PaulT95/smart-grind-by-weight/media/Digital_knob_installation/Step_0b.png

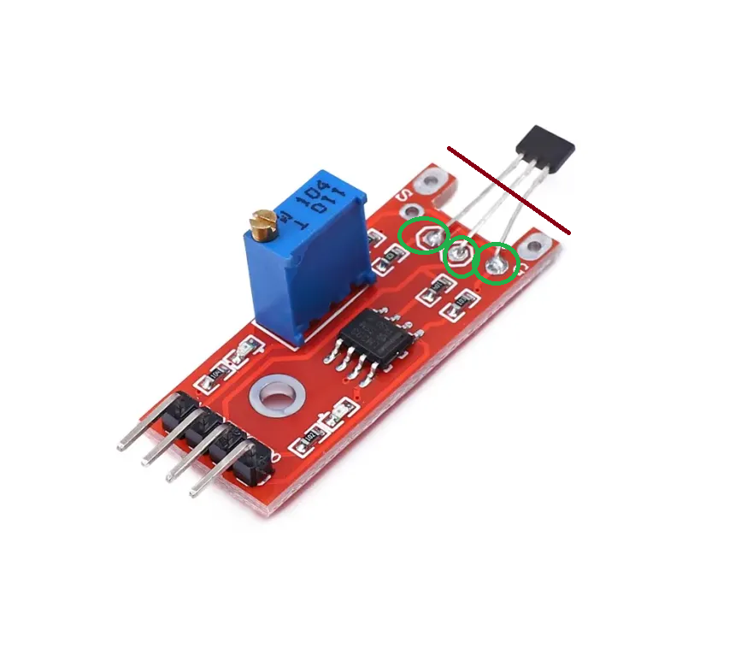
media/Digital_knob_installation/Step_0b.png
