PaulT95/smart-grind-by-weight/3d_files/Hall_sensor_adapter.stl

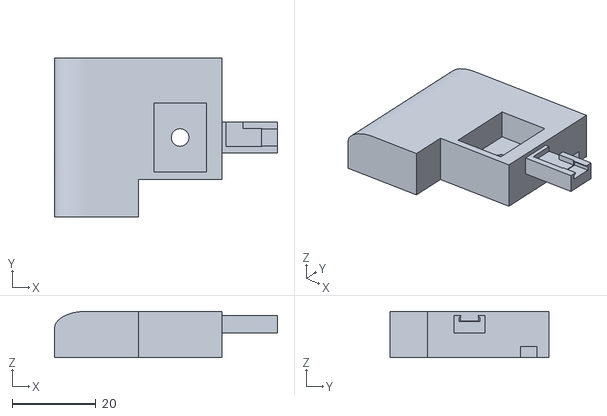
[picture p3: CAD file, 2026-10-31]
3d_files/Hall_sensor_adapter.stl
53.2 x 38.0 x 11.0
