PaulT95/smart-grind-by-weight/media/Digital_knob_installation/Step_0a.jpg

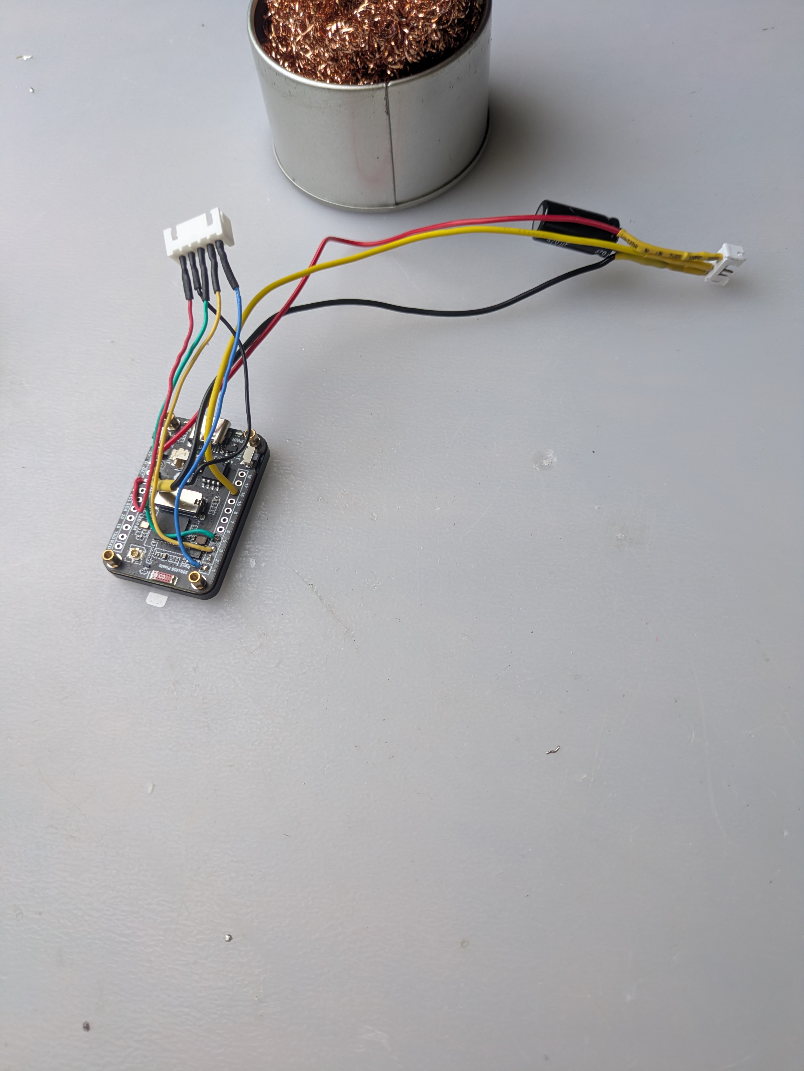
media/Digital_knob_installation/Step_0a.jpg
