PaulT95/smart-grind-by-weight/media/Digital_knob_installation/Step_3.jpg

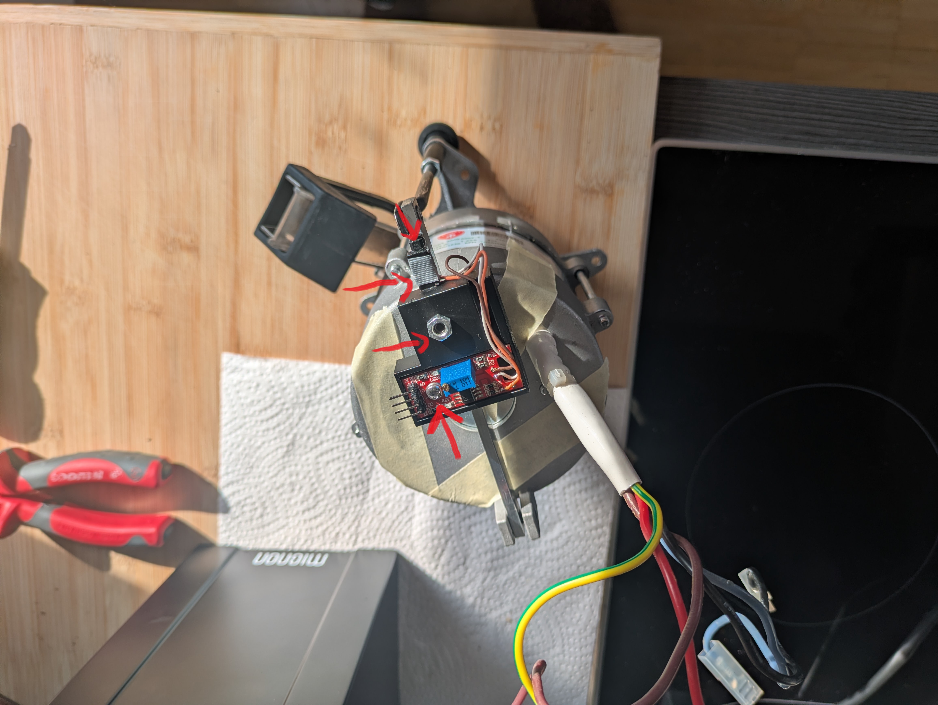
media/Digital_knob_installation/Step_3.jpg
