PaulT95/smart-grind-by-weight/media/Digital_knob_installation/Step_4.jpg

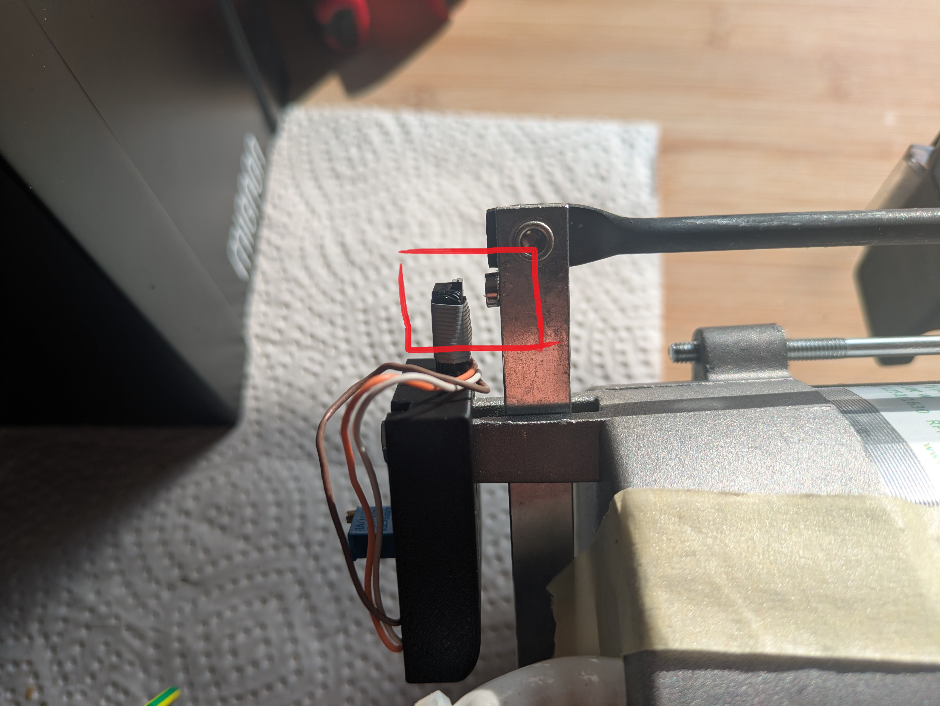
media/Digital_knob_installation/Step_4.jpg
