PaulT95/smart-grind-by-weight/media/Digital_knob_installation/Step_5.jpg

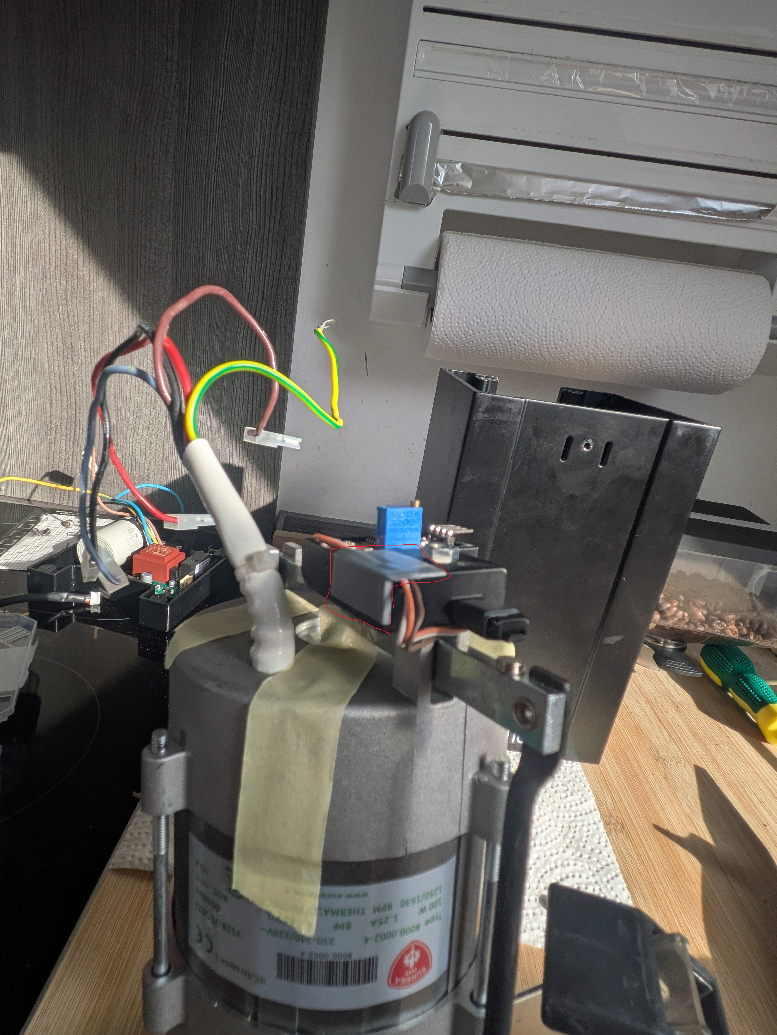
media/Digital_knob_installation/Step_5.jpg
