PaulT95/smart-grind-by-weight/media/Digital_knob_installation/Step_6.jpg

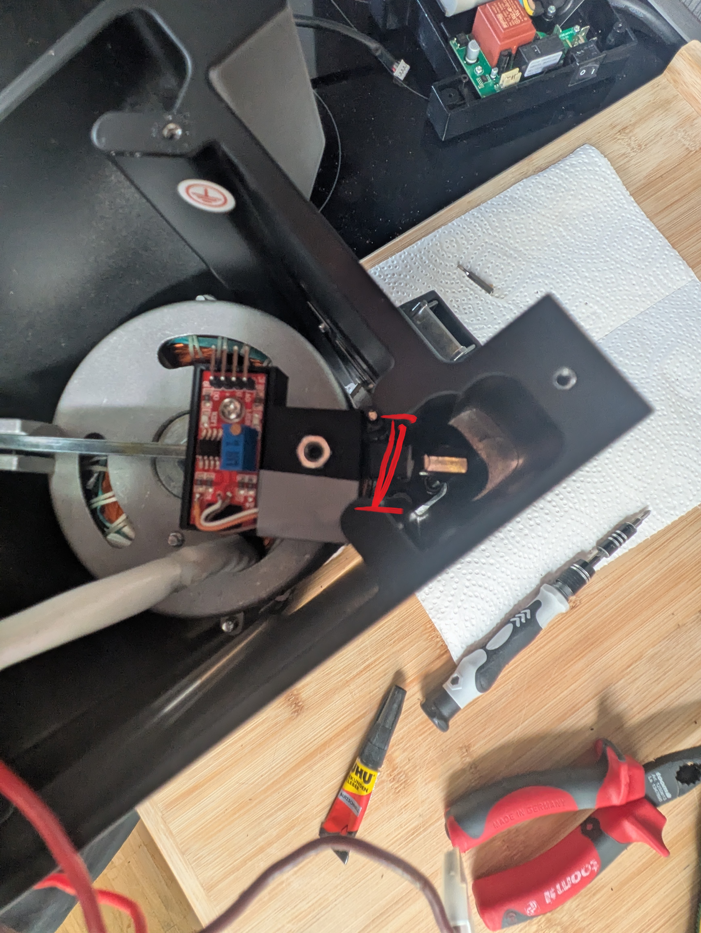
media/Digital_knob_installation/Step_6.jpg
