PaulT95/smart-grind-by-weight/src/config/hardware.h

#pragma once

//==============================================================================
// HARDWARE CONFIGURATION CONSTANTS
//==============================================================================
// This file contains hardware-specific configuration values that define the
// physical characteristics and constraints of the ESP32-S3 coffee grinder system.
// These values are tied to the specific hardware implementation and should only
// be modified when changing hardware components.

//------------------------------------------------------------------------------
// GPIO PIN ASSIGNMENTS
//------------------------------------------------------------------------------
// Touch Controller (I2C)
#define HW_TOUCH_I2C_SDA_PIN 47                                                // I2C data pin for capacitive touch controller
#define HW_TOUCH_I2C_SCL_PIN 48                                                // I2C clock pin for capacitive touch controller
#define HW_TOUCH_I2C_ADDRESS 0x38                                              // I2C address of FT3168 touch controller

// Display Controller (QSPI)
#ifndef HW_DISPLAY_VARIANT_V2
#define HW_DISPLAY_VARIANT_V2 0                                               // V1 remains the default hardware target
#endif

#if HW_DISPLAY_VARIANT_V2 != 0 && HW_DISPLAY_VARIANT_V2 != 1
#error "HW_DISPLAY_VARIANT_V2 must be either 0 or 1"
#endif

#if HW_DISPLAY_VARIANT_V2
#define HW_DISPLAY_REVISION "v2"
#define HW_DISPLAY_DESCRIPTION "Waveshare ESP32-S3 Touch AMOLED 1.64 V2"
#define HW_RELEASE_FIRMWARE_SUFFIX "-waveshare-164-v2"
#define HW_DISPLAY_CS_PIN 46                                                   // V2 PCB chip select for SH8601 display controller
#else
#define HW_DISPLAY_REVISION "v1"
#define HW_DISPLAY_DESCRIPTION "Waveshare ESP32-S3 Touch AMOLED 1.64 V1"
#define HW_RELEASE_FIRMWARE_SUFFIX ""
#define HW_DISPLAY_CS_PIN 9                                                    // V1 PCB chip select for CO5300 display controller
#endif
#define HW_DISPLAY_SCK_PIN 10                                                  // SPI clock for display controller
#define HW_DISPLAY_D0_PIN 11                                                   // SPI data line 0 (QSPI mode)
#define HW_DISPLAY_D1_PIN 12                                                   // SPI data line 1 (QSPI mode)
#define HW_DISPLAY_D2_PIN 13                                                   // SPI data line 2 (QSPI mode)
#define HW_DISPLAY_D3_PIN 14                                                   // SPI data line 3 (QSPI mode)
#define HW_DISPLAY_RESET_PIN 21                                                // Display reset pin

// Load Cell ADC Pins
#define HW_LOADCELL_DOUT_PIN 3                                                 // HX711 data output pin
#if HW_DISPLAY_VARIANT_V2
#define HW_LOADCELL_SCK_PIN 1                                                  // V2 wiring; GPIO2 is bypassed on this board revision
#else
#define HW_LOADCELL_SCK_PIN 2                                                  // V1 HX711 serial clock pin
#endif

// Motor Control
#if HW_DISPLAY_VARIANT_V2
#define HW_MOTOR_RELAY_PIN 16                                                  // V2: GPIO18 is shared with TP_INT and must not drive the grinder
#else
#define HW_MOTOR_RELAY_PIN 18                                                  // V1 grinder motor control relay
#endif
#define HW_GRINDER_SETTLING_TIME_MS 500                                        // Startup transient immunity (tune based on mechanical rigidity, 0 to disable)

//------------------------------------------------------------------------------
// LOAD CELL ADC SPECIFICATIONS
//------------------------------------------------------------------------------
// Sample rate configuration
#define HW_LOADCELL_SAMPLE_RATE_SPS 10                                         // Current sample rate setting
#define HW_LOADCELL_SAMPLE_INTERVAL_MS (1000 / HW_LOADCELL_SAMPLE_RATE_SPS)   // Calculated sample interval

// Calibration validation
#define HW_LOADCELL_CAL_MIN_ADC_VALUE 1000                                    // Minimum ADC value to confirm weight placed on scale

//------------------------------------------------------------------------------
// DISPLAY SPECIFICATIONS  
//------------------------------------------------------------------------------
#define HW_DISPLAY_WIDTH_PX 280                                                // LCD width in pixels
#define HW_DISPLAY_HEIGHT_PX 456                                               // LCD height in pixels
#define HW_DISPLAY_ROTATION_DEG 0                                              // Display rotation angle
#if HW_DISPLAY_VARIANT_V2
#define HW_DISPLAY_OFFSET_X_PX 20                                              // SH8601 framebuffer column offset
#define HW_DISPLAY_QSPI_FREQUENCY_HZ 40000000                                  // Waveshare V2 reference QSPI clock
#else
#define HW_DISPLAY_OFFSET_X_PX 0                                               // V1 display positioning offset
#define HW_DISPLAY_IPS_INVERT_X 180                                            // IPS X-axis inversion setting
#define HW_DISPLAY_IPS_INVERT_Y 24                                             // IPS Y-axis inversion setting
#define HW_DISPLAY_COLOR_ORDER 20                                              // Color channel ordering
#endif
#define HW_DISPLAY_MINIMAL_BRIGHTNESS_PERCENT 15                               // Minimum brightness percentage (to avoid too dim to see)

//------------------------------------------------------------------------------
// HALL EFFECT SENSOR (KY-024)
//------------------------------------------------------------------------------
#define HW_HALL_ADC_PIN 5                                                      // ADC1 channel 4, safe with Wi-Fi/BLE
#define HW_HALL_NUM_SAMPLES 50                                                 // Averaging samples per reading
#define HW_HALL_NUM_CAL_POINTS 6                                               // 6-point calibration table [0 to 5 are usually enough were 0 is touching]
#define HW_HALL_PREFS_NS "hall"                                                // Preferences namespace for calibration

//------------------------------------------------------------------------------
// SERIAL COMMUNICATION
//------------------------------------------------------------------------------
#define HW_SERIAL_BAUD_RATE 115200                                             // UART baud rate for debug/logging output
