PaulT95/smart-grind-by-weight/src/hardware/hardware_manager.h

#pragma once
#include <Preferences.h>
#include "display_manager.h"
#include "WeightSensor.h"
#include "grinder.h"
#include "HallSensor.h"
#include "../controllers/autotune_controller.h"

class GrindController; // Forward declaration

class HardwareManager {
private:
    DisplayManager display_manager;
    WeightSensor weight_sensor;
    Grinder grinder;
    HallSensor hall_sensor;
    Preferences preferences;
    AutoTuneController autotune_controller;
    bool initialized;
    GrindController* grind_controller; // Reference to get grinding state
    
public:
    void init();
    void update();
    void set_grind_controller(GrindController* gc) {
        grind_controller = gc;
        // Initialize autotune controller with grind controller reference
        autotune_controller.init(&weight_sensor, &grinder, gc);
    }
    
    DisplayManager* get_display() { return &display_manager; }
    WeightSensor* get_weight_sensor() { return &weight_sensor; }
    WeightSensor* get_load_cell() { return &weight_sensor; } // Legacy compatibility
    Grinder* get_grinder() { return &grinder; }
    HallSensor* get_hall_sensor() { return &hall_sensor; }
    Preferences* get_preferences() { return &preferences; }
    AutoTuneController* get_autotune_controller() { return &autotune_controller; }
    
    bool is_initialized() const { return initialized; }
};
