PaulT95/smart-grind-by-weight/src/network/device_api.cpp

#include "device_api.h"

#include <algorithm>
#include <cmath>
#include <cctype>
#include <cstring>
#include <LittleFS.h>
#include <esp_random.h>

#include "../controllers/grind_controller.h"
#include "../controllers/profile_controller.h"
#include "../config/constants.h"
#include "../hardware/WeightSensor.h"
#include "../hardware/grinder.h"
#include "../hardware/hardware_manager.h"
#include "../hardware/HallSensor.h"
#include "../system/screensaver_settings.h"
#include "../system/operation_interlock.h"
#include "device_web_server.h"
#include "gaggimate_status_client.h"

DeviceApi device_api;

namespace {
bool contains_json_string(const char* json, const char* key, const char* value) {
    if (!json || !key || !value) return false;
    const String needle = "\"" + String(key) + "\"";
    const char* cursor = strstr(json, needle.c_str());
    if (!cursor) return false;
    cursor += needle.length();
    while (*cursor == ' ' || *cursor == '\t' || *cursor == '\r' || *cursor == '\n') ++cursor;
    if (*cursor++ != ':') return false;
    while (*cursor == ' ' || *cursor == '\t' || *cursor == '\r' || *cursor == '\n') ++cursor;
    if (*cursor++ != '\"') return false;
    const size_t value_length = strlen(value);
    return strncmp(cursor, value, value_length) == 0 && cursor[value_length] == '\"';
}

bool extract_json_uint(const char* json, const char* key, uint32_t& value) {
    if (!json || !key) return false;
    const String needle = "\"" + String(key) + "\"";
    const char* cursor = strstr(json, needle.c_str());
    if (!cursor) return false;
    cursor += needle.length();
    while (*cursor == ' ' || *cursor == '\t' || *cursor == '\r' || *cursor == '\n') ++cursor;
    if (*cursor++ != ':') return false;
    while (*cursor == ' ' || *cursor == '\t' || *cursor == '\r' || *cursor == '\n') ++cursor;
    if (*cursor < '0' || *cursor > '9') return false;

    uint64_t parsed = 0;
    while (*cursor >= '0' && *cursor <= '9') {
        parsed = parsed * 10U + static_cast<uint8_t>(*cursor - '0');
        if (parsed > 0xFFFFFFFFULL) return false;
        ++cursor;
    }
    while (*cursor == ' ' || *cursor == '\t' || *cursor == '\r' || *cursor == '\n') ++cursor;
    if (*cursor != ',' && *cursor != '}') return false;
    value = static_cast<uint32_t>(parsed);
    return true;
}

bool websocket_origin_allowed(AsyncWebServerRequest* request) {
    if (!request || !request->hasHeader("Origin")) return true;
    const AsyncWebHeader* origin_header = request->getHeader("Origin");
    if (!origin_header) return false;
    return origin_header->value() == ("http://" + request->host());
}

bool valid_local_host(const String& host) {
    if (host.isEmpty() || host.length() > 63) return false;
    for (size_t index = 0; index < host.length(); ++index) {
        const char value = host[index];
        if (!isalnum(static_cast<unsigned char>(value)) && value != '.' && value != '-') {
            return false;
        }
    }
    return true;
}

const char* api_phase_name(const GrindController& controller) {
    switch (controller.get_phase()) {
        case GrindPhase::IDLE:
            return "IDLE";
        case GrindPhase::INITIALIZING:
        case GrindPhase::SETUP:
        case GrindPhase::TARING:
        case GrindPhase::TARE_CONFIRM:
            return "PREPARING";
        case GrindPhase::PRIME:
        case GrindPhase::PRIME_SETTLING:
        case GrindPhase::PURGE_CONFIRM:
            return "PRIMING";
        case GrindPhase::PREDICTIVE:
        case GrindPhase::PULSE_EXECUTE:
        case GrindPhase::TIME_ADDITIONAL_PULSE:
            return "GRINDING";
        case GrindPhase::TIME_GRINDING:
            return controller.is_grind_paused() ? "PAUSED" : "GRINDING";
        case GrindPhase::MANUAL_GRINDING:
            return "GRINDING";
        case GrindPhase::PULSE_DECISION:
        case GrindPhase::PULSE_SETTLING:
            return "COASTING";
        case GrindPhase::FINAL_SETTLING:
            return "FINAL_SETTLING";
        case GrindPhase::COMPLETED:
            return "COMPLETED";
        case GrindPhase::TIMEOUT:
            return "TIMEOUT";
    }
    return "IDLE";
}
}

void DeviceApi::init(AsyncWebServer* server, HardwareManager* hardware,
                     GrindController* grind_controller, ProfileController* profile_controller) {
    if (initialized_ || !server || !hardware || !grind_controller || !profile_controller) return;
    hardware_ = hardware;
    grind_controller_ = grind_controller;
    profile_controller_ = profile_controller;
    command_queue_ = xQueueCreate(8, sizeof(Command));
    settings_mutex_ = xSemaphoreCreateMutex();
    if (!command_queue_ || !settings_mutex_) {
        hardware_ = nullptr;
        grind_controller_ = nullptr;
        profile_controller_ = nullptr;
        return;
    }
    websocket_.onEvent([this](AsyncWebSocket* ws, AsyncWebSocketClient* client,
                              AwsEventType type, void* arg, uint8_t* data, size_t len) {
        handle_event(ws, client, type, arg, data, len);
    });
    websocket_.handleHandshake(websocket_origin_allowed);
    server->addHandler(&websocket_);
    configure_settings_routes(server);
    // Avoid mistaking a previous boot's result for a newly queued request.
    next_settings_id_ = esp_random();
    refresh_settings_cache();
    initialized_ = true;
}

bool form_bool(const String& value) {
    return value == "1" || value == "true" || value == "on";
}

void DeviceApi::update() {
    if (!initialized_) return;
    if (settings_cache_dirty_.exchange(false)) refresh_settings_cache();
    websocket_.cleanupClients(MAX_CLIENTS);
    const uint32_t now = millis();
    if (now - last_publish_ms_ < PUBLISH_INTERVAL_MS) return;
    last_publish_ms_ = now;

    const String message = build_state_message();
    for (size_t index = 0; index < MAX_CLIENTS; ++index) {
        auto& slot = client_ids_[index];
        const uint32_t id = slot.load();
        if (id == 0) {
            backpressure_skips_[index].store(0);
            continue;
        }
        if (!websocket_.hasClient(id)) {
            slot.store(0);
            backpressure_skips_[index].store(0);
            continue;
        }
        if (!websocket_.availableForWrite(id)) {
            uint8_t skipped = backpressure_skips_[index].load();
            if (skipped < MAX_CONSECUTIVE_BACKPRESSURE_SKIPS) ++skipped;
            backpressure_skips_[index].store(skipped);
            if (skipped >= MAX_CONSECUTIVE_BACKPRESSURE_SKIPS) {
                LOG_BLE("[WEB] Closing WebSocket client %lu after sustained backpressure\n",
                        static_cast<unsigned long>(id));
                websocket_.close(id, 1013, "client remained too slow");
                slot.store(0);
                backpressure_skips_[index].store(0);
            }
            continue;
        }
        backpressure_skips_[index].store(0);
        websocket_.text(id, message);
    }
}

bool DeviceApi::process_commands() {
    if (!initialized_) return false;
    if (applying_settings_id_) return true;
    bool settings_changed = false;
    Command command{};
    while (xQueueReceive(command_queue_, &command, 0) == pdTRUE) {
        // Keep the idle check and its action together with controller updates.
        const auto control_lock = grind_controller_->lock_control();
        switch (command.action) {
            case CommandAction::START: {
                if (device_web_server.is_ota_active() || device_web_server.is_ota_preparing()) {
                    send_ack(command, "start", false, "firmware update is active");
                    break;
                }
                if (grind_controller_->get_phase() != GrindPhase::IDLE) {
                    send_ack(command, "start", false, "grinder is not idle");
                    break;
                }
                const auto profile = profile_controller_->snapshot();
                const GrindMode mode = profile.mode;
                WeightSensor* sensor = hardware_->get_weight_sensor();
                if (mode == GrindMode::WEIGHT &&
                    (!sensor || sensor->has_hardware_fault())) {
                    send_ack(command, "start", false, "load cell is not ready");
                    break;
                }
                grind_controller_->set_grind_profile_id(profile.current_profile);
                const float target_weight = profile.profiles[profile.current_profile].weight;
                const uint32_t target_time_ms = static_cast<uint32_t>(
                    profile.profiles[profile.current_profile].time_seconds * 1000.0f + 0.5f);
                const bool started = grind_controller_->start_grind(target_weight, target_time_ms, mode);
                send_ack(command, "start", started, started ? "grind started" : "grind could not start");
                break;
            }
            case CommandAction::START_MANUAL:
                if (device_web_server.is_ota_active() || device_web_server.is_ota_preparing()) {
                    send_ack(command, "start_manual", false, "firmware update is active");
                } else if (grind_controller_->get_phase() != GrindPhase::IDLE) {
                    send_ack(command, "start_manual", false, "grinder is not idle");
                } else {
                    const bool started = grind_controller_->start_grind(0.0f, 0, GrindMode::MANUAL);
                    send_ack(command, "start_manual", started,
                             started ? "manual grind started" : "grind could not start");
                }
                break;
            case CommandAction::STOP:
                if (!grind_controller_->is_active()) {
                    send_ack(command, "stop", false, "grinder is not active");
                } else {
                    grind_controller_->stop_grind();
                    send_ack(command, "stop", true, "grind stopped");
                }
                break;
            case CommandAction::DISMISS:
                if (grind_controller_->get_phase() != GrindPhase::COMPLETED &&
                    grind_controller_->get_phase() != GrindPhase::TIMEOUT) {
                    send_ack(command, "dismiss", false, "nothing to dismiss");
                } else {
                    grind_controller_->return_to_idle();
                    const bool dismissed = grind_controller_->get_phase() == GrindPhase::IDLE;
                    send_ack(command, "dismiss", dismissed,
                             dismissed ? "result dismissed" : "history completion is pending");
                }
                break;
            case CommandAction::TARE: {
                WeightSensor* sensor = hardware_->get_weight_sensor();
                if (grind_controller_->get_phase() != GrindPhase::IDLE) {
                    send_ack(command, "tare", false, "grinder is not idle");
                } else if (!sensor || sensor->has_hardware_fault() || sensor->get_sample_count() <= 0) {
                    send_ack(command, "tare", false, "load cell is not ready");
                } else if (sensor->is_tare_in_progress()) {
                    send_ack(command, "tare", false, "tare is already in progress");
                } else {
                    sensor->tareNoDelay();
                    send_ack(command, "tare", true, "tare started");
                }
                break;
            }
            case CommandAction::SELECT_PROFILE:
                if (grind_controller_->get_phase() != GrindPhase::IDLE) {
                    send_ack(command, "select_profile", false, "grinder is not idle");
                    break;
                }
                profile_controller_->set_current_profile(command.profile_index);
                settings_changed = true;
                LOG_BLE("[WEB] Active profile changed to %s\n",
                        profile_controller_->get_current_name());
                send_ack(command, "select_profile", true, "profile selected");
                break;
            case CommandAction::SET_MODE:
                if (grind_controller_->get_phase() != GrindPhase::IDLE) {
                    send_ack(command, "set_mode", false, "grinder is not idle");
                    break;
                }
                profile_controller_->set_grind_mode(
                    command.grind_mode == 1 ? GrindMode::TIME : GrindMode::WEIGHT);
                settings_changed = true;
                send_ack(command, "set_mode", true, "grind mode selected");
                break;
            case CommandAction::APPLY_SETTINGS: {
                settings_operation_token_ = operation_interlock().try_acquire();
                if (!settings_operation_token_) {
                    set_settings_result(command.request_id, "busy");
                    break;
                }
                applying_settings_id_ = command.request_id;
                settings_persisted_ = apply_settings(command.settings);
                // Even a failed multi-key save can change stored values. Return
                // now so UI runtime refresh finishes before any later command.
                refresh_settings_cache();
                return true;
            }
        }
    }
    if (settings_changed) refresh_settings_cache();
    return settings_changed;
}

uint32_t DeviceApi::reserve_settings_result() {
    xSemaphoreTake(settings_mutex_, portMAX_DELAY);
    for (const auto& result : settings_results_) {
        if (strcmp(result.status, "pending") == 0) {
            xSemaphoreGive(settings_mutex_);
            return 0;
        }
    }
    if (++next_settings_id_ == 0) ++next_settings_id_;
    const uint32_t id = next_settings_id_;
    settings_results_[next_settings_result_] = {id, "pending"};
    next_settings_result_ = (next_settings_result_ + 1) % 4;
    xSemaphoreGive(settings_mutex_);
    return id;
}

void DeviceApi::set_settings_result(uint32_t id, const char* status) {
    xSemaphoreTake(settings_mutex_, portMAX_DELAY);
    for (auto& result : settings_results_) {
        if (result.id == id) { result.status = status; break; }
    }
    xSemaphoreGive(settings_mutex_);
}

const char* DeviceApi::settings_result(uint32_t id) {
    const char* status = "unknown";
    xSemaphoreTake(settings_mutex_, portMAX_DELAY);
    for (const auto& result : settings_results_) {
        if (id && result.id == id) { status = result.status; break; }
    }
    xSemaphoreGive(settings_mutex_);
    return status; // All statuses are static literals, not pointers into a slot.
}

void DeviceApi::complete_settings_application(bool runtime_applied) {
    if (!applying_settings_id_) return;
    // Keep other operations excluded through persistence, cache and UI refresh.
    set_settings_result(applying_settings_id_, settings_persisted_ && runtime_applied ? "saved" : "failed");
    operation_interlock().release(settings_operation_token_);
    settings_operation_token_ = 0;
    applying_settings_id_ = 0;
}

void DeviceApi::handle_event(AsyncWebSocket*, AsyncWebSocketClient* client,
                             AwsEventType type, void* arg, uint8_t* data, size_t len) {
    if (!client) return;
    if (type == WS_EVT_CONNECT) {
        add_client(client);
        return;
    }
    if (type == WS_EVT_DISCONNECT || type == WS_EVT_ERROR) {
        remove_client(client->id());
        return;
    }
    if (type != WS_EVT_DATA || !arg || !data) return;
    auto* info = static_cast<AwsFrameInfo*>(arg);
    if (!info->final || info->index != 0 || info->len != len || info->opcode != WS_TEXT || len > 255) {
        client->close(1009, "single text frames only");
        return;
    }
    queue_command(client->id(), data, len);
}

void DeviceApi::add_client(AsyncWebSocketClient* client) {
    for (size_t index = 0; index < MAX_CLIENTS; ++index) {
        auto& slot = client_ids_[index];
        uint32_t empty = 0;
        if (slot.compare_exchange_strong(empty, client->id())) {
            backpressure_skips_[index].store(0);
            client->keepAlivePeriod(20);
            client->text(build_state_message());
            return;
        }
    }
    client->close(1013, "too many clients");
}

void DeviceApi::remove_client(uint32_t client_id) {
    for (size_t index = 0; index < MAX_CLIENTS; ++index) {
        auto& slot = client_ids_[index];
        uint32_t expected = client_id;
        if (slot.compare_exchange_strong(expected, 0)) {
            backpressure_skips_[index].store(0);
        }
    }
}

void DeviceApi::queue_command(uint32_t client_id, const uint8_t* data, size_t len) {
    char json[256];
    memcpy(json, data, len);
    json[len] = '\0';
    uint32_t request_id = 0;
    const bool has_request_id = extract_json_uint(json, "rid", request_id);
    if (!contains_json_string(json, "type", "command")) {
        send_ack(client_id, request_id, has_request_id, "unknown", false, "invalid message type");
        return;
    }

    Command command{};
    command.client_id = client_id;
    command.request_id = request_id;
    command.has_request_id = has_request_id;
    command.action = CommandAction::STOP;
    const char* action = nullptr;
    if (contains_json_string(json, "action", "start")) {
        action = "start";
        command.action = CommandAction::START;
    } else if (contains_json_string(json, "action", "start_manual")) {
        action = "start_manual";
        command.action = CommandAction::START_MANUAL;
    } else if (contains_json_string(json, "action", "stop")) {
        action = "stop";
        command.action = CommandAction::STOP;
    } else if (contains_json_string(json, "action", "dismiss")) {
        action = "dismiss";
        command.action = CommandAction::DISMISS;
    } else if (contains_json_string(json, "action", "tare")) {
        action = "tare";
        command.action = CommandAction::TARE;
    } else if (contains_json_string(json, "action", "select_profile")) {
        action = "select_profile";
        command.action = CommandAction::SELECT_PROFILE;
        uint32_t profile = 0;
        if (!extract_json_uint(json, "profile", profile) || profile >= USER_PROFILE_COUNT) {
            send_ack(command, action, false, "invalid profile");
            return;
        }
        command.profile_index = static_cast<int>(profile);
    } else if (contains_json_string(json, "action", "set_mode")) {
        action = "set_mode";
        command.action = CommandAction::SET_MODE;
        if (contains_json_string(json, "mode", "weight")) {
            command.grind_mode = 0;
        } else if (contains_json_string(json, "mode", "time")) {
            command.grind_mode = 1;
        } else {
            send_ack(command, action, false, "invalid grind mode");
            return;
        }
    } else {
        send_ack(client_id, request_id, has_request_id, "unknown", false, "unsupported action");
        return;
    }

    if (xQueueSend(command_queue_, &command, 0) != pdTRUE) {
        send_ack(command, action, false, "command queue busy");
    }
}

void DeviceApi::configure_settings_routes(AsyncWebServer* server) {
    server->on(AsyncURIMatcher::exact("/api/v1/settings/result"), HTTP_GET, [this](AsyncWebServerRequest* request) {
        uint32_t id = 0;
        bool valid = request->hasParam("id");
        if (valid) {
            const String value = request->getParam("id")->value();
            valid = !value.isEmpty() && value.length() <= 10;
            uint64_t parsed = 0;
            for (size_t i = 0; valid && i < value.length(); ++i) {
                valid = value[i] >= '0' && value[i] <= '9';
                if (valid) parsed = parsed * 10 + (value[i] - '0');
            }
            valid = valid && parsed > 0 && parsed <= UINT32_MAX;
            if (valid) id = static_cast<uint32_t>(parsed);
        }
        if (!valid) {
            request->send(400, "application/json", "{\"error\":\"Invalid settings request ID\"}");
            return;
        }
        const char* status = settings_result(id);
        char body[96];
        snprintf(body, sizeof(body), "{\"request_id\":%lu,\"status\":\"%s\"}",
                 static_cast<unsigned long>(id), status);
        auto* response = request->beginResponse(strcmp(status, "unknown") == 0 ? 404 : 200,
                                                "application/json", body);
        response->addHeader("Cache-Control", "no-store");
        request->send(response);
    });
    server->on(AsyncURIMatcher::exact("/api/v1/profile"), HTTP_POST, [this](AsyncWebServerRequest* request) {
        if (!websocket_origin_allowed(request)) {
            request->send(403, "application/json", "{\"error\":\"Request origin is not allowed\"}");
            return;
        }
        queue_profile_selection(request);
    });
    server->on(AsyncURIMatcher::exact("/api/v1/settings"), HTTP_GET, [this](AsyncWebServerRequest* request) {
        AsyncWebServerResponse* response = request->beginResponse(200, "application/json", settings_json());
        response->addHeader("Cache-Control", "no-store");
        request->send(response);
    });
    server->on(AsyncURIMatcher::exact("/api/v1/settings"), HTTP_POST, [this](AsyncWebServerRequest* request) {
        if (!websocket_origin_allowed(request)) {
            request->send(403, "application/json", "{\"error\":\"Request origin is not allowed\"}");
            return;
        }
        queue_settings_update(request);
    });
}

bool DeviceApi::queue_profile_selection(AsyncWebServerRequest* request) {
    if (!request->hasParam("profile", true)) {
        request->send(400, "application/json", "{\"error\":\"Missing profile\"}");
        return false;
    }
    const String value = request->getParam("profile", true)->value();
    if (value != "0" && value != "1" && value != "2") {
        request->send(400, "application/json", "{\"error\":\"Profile must be 0, 1 or 2\"}");
        return false;
    }
    if (grind_controller_->get_phase() != GrindPhase::IDLE) {
        request->send(409, "application/json", "{\"error\":\"Profiles can only be changed while the grinder is idle\"}");
        return false;
    }

    Command command{};
    command.action = CommandAction::SELECT_PROFILE;
    command.profile_index = value.toInt();
    if (xQueueSend(command_queue_, &command, 0) != pdTRUE) {
        request->send(503, "application/json", "{\"error\":\"Command queue is busy; try again\"}");
        return false;
    }
    request->send(202, "application/json", "{\"accepted\":true}");
    return true;
}

bool DeviceApi::queue_settings_update(AsyncWebServerRequest* request) {
    static const char* required[] = {
        "current_profile", "grind_mode", "weight0", "weight1", "weight2",
        "time0", "time1", "time2", "auto_start", "auto_return", "purge_mode",
        "purge_amount_g", "freshness_hours", "coast_ratio", "logging_enabled",
        "swipe_enabled", "brightness_percent", "screensaver_brightness_percent",
        "screensaver_startup", "screensaver_sleep", "screensaver_idle_timeout_s",
        "screensaver_startup_timeout_s",
        "screensaver_style", "bluetooth_startup"
    };
    for (const char* field : required) {
        if (!request->hasParam(field, true)) {
            request->send(400, "application/json", String("{\"error\":\"Missing field: ") + field + "\"}");
            return false;
        }
    }

    auto value = [request](const char* name) { return request->getParam(name, true)->value(); };
    DeviceSettingsUpdate settings{};
    settings.current_profile = value("current_profile").toInt();
    settings.grind_mode = value("grind_mode").toInt();
    for (int i = 0; i < 3; ++i) {
        settings.profile_weights[i] = value((String("weight") + i).c_str()).toFloat();
        settings.profile_times[i] = value((String("time") + i).c_str()).toFloat();
    }
    settings.auto_start = form_bool(value("auto_start"));
    if (request->hasParam("auto_start_threshold_g", true)) {
        settings.auto_start_threshold_g = value("auto_start_threshold_g").toFloat();
    } else {
        Preferences auto_preferences;
        if (auto_preferences.begin("autogrind", true)) {
            settings.auto_start_threshold_g = auto_preferences.getFloat(
                "start_delta_g", USER_AUTO_GRIND_TRIGGER_DELTA_G);
            auto_preferences.end();
        }
    }
    settings.auto_return = form_bool(value("auto_return"));
    settings.purge_mode = value("purge_mode").toInt();
    settings.purge_amount_g = value("purge_amount_g").toFloat();
    settings.freshness_hours = value("freshness_hours").toFloat();
    settings.coast_ratio = value("coast_ratio").toFloat();
    settings.motor_latency_ms = request->hasParam("motor_latency_ms", true)
                                    ? value("motor_latency_ms").toFloat()
                                    : grind_controller_->get_motor_response_latency();
    settings.logging_enabled = form_bool(value("logging_enabled"));
    settings.swipe_enabled = form_bool(value("swipe_enabled"));
    settings.brightness_percent = value("brightness_percent").toInt();
    settings.screensaver_brightness_percent = value("screensaver_brightness_percent").toInt();
    settings.screensaver_startup = form_bool(value("screensaver_startup"));
    settings.screensaver_sleep = form_bool(value("screensaver_sleep"));
    const long screensaver_idle_timeout_s = value("screensaver_idle_timeout_s").toInt();
    const long screensaver_startup_timeout_s = value("screensaver_startup_timeout_s").toInt();
    // Older web pages predate panel-off settings. Preserve the stored values
    // rather than rejecting the whole form or silently resetting the option.
    settings.has_display_off_enabled = request->hasParam("display_off_enabled", true);
    settings.has_display_off_delay_s = request->hasParam("display_off_delay_s", true);
    const long display_off_delay_s = settings.has_display_off_delay_s
                                         ? value("display_off_delay_s").toInt()
                                         : settings.display_off_delay_s;
    settings.screensaver_idle_timeout_s = static_cast<uint16_t>(screensaver_idle_timeout_s);
    settings.screensaver_startup_timeout_s = static_cast<uint8_t>(screensaver_startup_timeout_s);
    settings.display_off_enabled = settings.has_display_off_enabled
                                       ? form_bool(value("display_off_enabled"))
                                       : settings.display_off_enabled;
    settings.display_off_delay_s = static_cast<uint16_t>(display_off_delay_s);
    const String screensaver_style = value("screensaver_style");
    strncpy(settings.screensaver_style, screensaver_style.c_str(), sizeof(settings.screensaver_style) - 1);
    const String gaggimate_host = request->hasParam("gaggimate_host", true)
                                      ? value("gaggimate_host")
                                      : gaggimate_status_client.configured_host();
    strncpy(settings.gaggimate_host, gaggimate_host.c_str(), sizeof(settings.gaggimate_host) - 1);
    settings.bluetooth_startup = form_bool(value("bluetooth_startup"));

    bool valid = settings.current_profile >= 0 && settings.current_profile < USER_PROFILE_COUNT &&
                 settings.grind_mode >= 0 && settings.grind_mode <= 1 &&
                 std::isfinite(settings.auto_start_threshold_g) &&
                 settings.auto_start_threshold_g >= USER_AUTO_GRIND_TRIGGER_MIN_G &&
                 settings.auto_start_threshold_g <= USER_AUTO_GRIND_TRIGGER_MAX_G &&
                 settings.purge_mode >= 0 && settings.purge_mode <= 1 &&
                 std::isfinite(settings.purge_amount_g) &&
                 settings.purge_amount_g >= GRIND_PURGE_AMOUNT_MIN_G &&
                 settings.purge_amount_g <= GRIND_PURGE_AMOUNT_MAX_G &&
                 std::isfinite(settings.freshness_hours) && settings.freshness_hours >= 0.5f &&
                 settings.freshness_hours <= 48.0f && std::isfinite(settings.coast_ratio) &&
                 settings.coast_ratio >= GRIND_LATENCY_TO_COAST_RATIO_MIN &&
                 settings.coast_ratio <= GRIND_LATENCY_TO_COAST_RATIO_MAX &&
                 std::isfinite(settings.motor_latency_ms) &&
                 settings.motor_latency_ms >= GRIND_AUTOTUNE_LATENCY_MIN_MS &&
                 settings.motor_latency_ms <= GRIND_AUTOTUNE_LATENCY_MAX_MS &&
                 std::fabs(settings.motor_latency_ms / GRIND_MOTOR_LATENCY_MANUAL_STEP_MS -
                           std::round(settings.motor_latency_ms /
                                      GRIND_MOTOR_LATENCY_MANUAL_STEP_MS)) < 0.001f &&
                 settings.brightness_percent >= HW_DISPLAY_MINIMAL_BRIGHTNESS_PERCENT &&
                 settings.brightness_percent <= 100 &&
                 settings.screensaver_brightness_percent >= HW_DISPLAY_MINIMAL_BRIGHTNESS_PERCENT &&
                 settings.screensaver_brightness_percent <= 100 &&
                 screensaver_idle_timeout_s >= 0 && screensaver_idle_timeout_s <= 65535 &&
                 screensaver_startup_timeout_s >= 0 && screensaver_startup_timeout_s <= 255 &&
                 display_off_delay_s >= 0 && display_off_delay_s <= 65535 &&
                 ScreensaverSettings::is_valid_idle_timeout(settings.screensaver_idle_timeout_s) &&
                 ScreensaverSettings::is_valid_startup_timeout(settings.screensaver_startup_timeout_s) &&
                 ScreensaverSettings::is_valid_display_off_delay(settings.display_off_delay_s) &&
                 (screensaver_style == "orbit" || screensaver_style == "minimal" ||
                  screensaver_style == "blank" ||
                  (screensaver_style == "custom" && LittleFS.exists(BLE_IMAGE_FILENAME)) ||
                  (screensaver_style == "gaggimate" && valid_local_host(gaggimate_host)));
    for (int i = 0; i < 3 && valid; ++i) {
        valid = std::isfinite(settings.profile_weights[i]) &&
                profile_controller_->is_weight_valid(settings.profile_weights[i]) &&
                std::isfinite(settings.profile_times[i]) &&
                profile_controller_->is_time_valid(settings.profile_times[i]);
    }
    if (!valid) {
        request->send(400, "application/json", "{\"error\":\"One or more settings are outside the supported range\"}");
        return false;
    }
    if (grind_controller_->is_active()) {
        request->send(409, "application/json", "{\"error\":\"Stop the grinder before changing settings\"}");
        return false;
    }

    Command command{};
    command.action = CommandAction::APPLY_SETTINGS;
    command.settings = settings;
    command.request_id = reserve_settings_result();
    if (!command.request_id) {
        request->send(409, "application/json", "{\"error\":\"A settings save is still pending\"}");
        return false;
    }
    if (xQueueSend(command_queue_, &command, 0) != pdTRUE) {
        set_settings_result(command.request_id, "failed");
        request->send(503, "application/json", "{\"error\":\"Settings queue is busy; try again\"}");
        return false;
    }
    request->send(202, "application/json", String("{\"accepted\":true,\"request_id\":") + command.request_id + "}");
    return true;
}

bool DeviceApi::apply_settings(const DeviceSettingsUpdate& update) {
    if (!hardware_ || !profile_controller_ || !grind_controller_ || grind_controller_->is_active()) return false;
    DeviceSettingsUpdate settings = update;
    // Resolve omissions when executing, after earlier queued saves have applied.
    if (!settings.has_display_off_enabled || !settings.has_display_off_delay_s) {
        const auto stored_timing = ScreensaverSettings::load_timing();
        if (!settings.has_display_off_enabled) settings.display_off_enabled = stored_timing.display_off_enabled;
        if (!settings.has_display_off_delay_s) settings.display_off_delay_s = stored_timing.display_off_delay_s;
    }
    Preferences* grinder = hardware_->get_preferences();
    if (!grinder) return false;
    bool saved = profile_controller_->apply_web_settings(
            settings.current_profile,
            settings.grind_mode == 0 ? GrindMode::WEIGHT : GrindMode::TIME,
            settings.profile_weights, settings.profile_times);

    saved = (grinder->putInt(GrindController::PREF_KEY_GRINDER_MODE, settings.purge_mode) == sizeof(int32_t)) && saved;
    saved = (grinder->putFloat(GrindController::PREF_KEY_GRINDER_AMOUNT_G, settings.purge_amount_g) == sizeof(float)) && saved;
    saved = (grinder->putFloat(GrindController::PREF_KEY_GRIND_FRESHNESS_HOURS, settings.freshness_hours) == sizeof(float)) && saved;
    saved = grind_controller_->save_coast_ratio(settings.coast_ratio) && saved;
    saved = grind_controller_->save_motor_latency(settings.motor_latency_ms) && saved;

    auto put_bool = [](const char* name_space, const char* key, bool value) {
        Preferences preferences;
        if (!preferences.begin(name_space, false)) return false;
        const bool stored = preferences.putBool(key, value) == sizeof(bool);
        preferences.end();
        return stored;
    };
    saved = put_bool("autogrind", "auto_start", settings.auto_start) && saved;
    saved = put_bool("autogrind", "auto_return", settings.auto_return) && saved;
    Preferences auto_preferences;
    if (auto_preferences.begin("autogrind", false)) {
        saved = (auto_preferences.putFloat("start_delta_g", settings.auto_start_threshold_g) == sizeof(float)) && saved;
        auto_preferences.end();
    } else {
        saved = false;
    }
    saved = put_bool("logging", "enabled", settings.logging_enabled) && saved;
    saved = put_bool("swipe", "enabled", settings.swipe_enabled) && saved;
    saved = put_bool("screensaver", "startup", settings.screensaver_startup) && saved;
    saved = put_bool("screensaver", "sleep", settings.screensaver_sleep) && saved;
    saved = put_bool("bluetooth", "startup", settings.bluetooth_startup) && saved;

    Preferences brightness;
    if (brightness.begin("brightness", false)) {
        const bool normal_saved = brightness.putFloat("normal", settings.brightness_percent / 100.0f) == sizeof(float);
        saved = normal_saved && saved;
        saved = (brightness.putFloat("screensaver", settings.screensaver_brightness_percent / 100.0f) == sizeof(float)) && saved;
        brightness.end();
        if (normal_saved && hardware_->get_display()) {
            hardware_->get_display()->set_brightness(settings.brightness_percent / 100.0f);
        }
    } else {
        saved = false;
    }
    if (!ScreensaverSettings::save_timing(settings.screensaver_idle_timeout_s,
                                          settings.screensaver_startup_timeout_s,
                                          settings.display_off_enabled,
                                          settings.display_off_delay_s)) {
        saved = false;
    }
    Preferences screensaver;
    if (screensaver.begin("screensaver", false)) {
        const bool style_saved = screensaver.putString("style", settings.screensaver_style) == strlen(settings.screensaver_style);
        saved = style_saved && saved;
        const String stored_style = screensaver.getString("style", "");
        screensaver.end();
        const bool style_read = stored_style == "minimal" || stored_style == "orbit" ||
                                stored_style == "blank" || stored_style == "custom" ||
                                stored_style == "gaggimate";
        if (style_read) {
            saved = gaggimate_status_client.configure(stored_style == "gaggimate",
                                                      settings.gaggimate_host) && saved;
        } else {
            // Keep the active client unchanged when stored style is unreadable.
            saved = false;
        }
    } else {
        saved = false;
    }
    LOG_BLE("[WEB] Grinder settings %s\n", saved ? "updated" : "partly saved; storage or runtime setup failed");
    return saved;
}

String DeviceApi::settings_json() {
    if (!settings_mutex_) return "{}";
    xSemaphoreTake(settings_mutex_, portMAX_DELAY);
    const String copy = settings_json_cache_;
    xSemaphoreGive(settings_mutex_);
    return copy;
}

void DeviceApi::refresh_settings_cache() {
    if (!profile_controller_ || !hardware_ || !grind_controller_ || !settings_mutex_) return;
    const auto profile = profile_controller_->snapshot();
    auto read_bool = [](const char* name_space, const char* key, bool fallback) {
        Preferences preferences;
        if (!preferences.begin(name_space, true)) return fallback;
        const bool value = preferences.getBool(key, fallback);
        preferences.end();
        return value;
    };
    auto read_brightness = [](const char* key, float fallback) {
        Preferences preferences;
        if (!preferences.begin("brightness", true)) return fallback;
        const float value = preferences.getFloat(key, fallback);
        preferences.end();
        return value;
    };
    auto read_float = [](const char* name_space, const char* key, float fallback) {
        Preferences preferences;
        if (!preferences.begin(name_space, true)) return fallback;
        const float value = preferences.getFloat(key, fallback);
        preferences.end();
        return value;
    };
    Preferences* grinder = hardware_->get_preferences();
    const int purge_mode = grinder->getInt(GrindController::PREF_KEY_GRINDER_MODE, GRIND_PURGE_MODE_DEFAULT);
    const float purge_amount = grinder->getFloat(GrindController::PREF_KEY_GRINDER_AMOUNT_G, GRIND_PURGE_AMOUNT_DEFAULT_G);
    const float freshness = grinder->getFloat(GrindController::PREF_KEY_GRIND_FRESHNESS_HOURS, GRIND_FRESHNESS_DEFAULT_HOURS);
    const ScreensaverTimingSettings screensaver_timing = ScreensaverSettings::load_timing();
    Preferences screensaver_preferences;
    String screensaver_style = LittleFS.exists(BLE_IMAGE_FILENAME) ? "custom" : "minimal";
    if (screensaver_preferences.begin("screensaver", true)) {
        screensaver_style = screensaver_preferences.getString("style", screensaver_style);
        screensaver_preferences.end();
    }
    const String gaggimate_host = gaggimate_status_client.configured_host();

    char json[2048];
    snprintf(json, sizeof(json),
             "{\"api\":\"v1\",\"current_profile\":%d,\"grind_mode\":\"%s\","
             "\"profiles\":["
             "{\"id\":0,\"name\":\"%s\",\"weight\":%.2f,\"time\":%.2f},"
             "{\"id\":1,\"name\":\"%s\",\"weight\":%.2f,\"time\":%.2f},"
             "{\"id\":2,\"name\":\"%s\",\"weight\":%.2f,\"time\":%.2f}],"
             "\"automatic\":{\"start\":%s,\"threshold_g\":%.1f,\"return\":%s},"
             "\"purge\":{\"mode\":%d,\"amount_g\":%.2f,\"freshness_hours\":%.2f},"
             "\"coast_ratio\":%.2f,\"motor_latency_ms\":%.0f,"
             "\"logging_enabled\":%s,\"swipe_enabled\":%s,"
             "\"display\":{\"brightness\":%d,\"screensaver_brightness\":%d,"
             "\"screensaver_startup\":%s,\"screensaver_sleep\":%s,"
             "\"screensaver_idle_timeout_s\":%u,\"screensaver_startup_timeout_s\":%u,"
             "\"display_off_enabled\":%s,\"display_off_delay_s\":%u,"
             "\"screensaver_style\":\"%s\",\"has_custom_screensaver\":%s,"
             "\"gaggimate_host\":\"%s\"},"
             "\"bluetooth_startup\":%s}",
             profile.current_profile,
             profile.mode == GrindMode::TIME ? "time" : "weight",
             profile.profiles[0].name, profile.profiles[0].weight, profile.profiles[0].time_seconds,
             profile.profiles[1].name, profile.profiles[1].weight, profile.profiles[1].time_seconds,
             profile.profiles[2].name, profile.profiles[2].weight, profile.profiles[2].time_seconds,
             read_bool("autogrind", "auto_start", false) ? "true" : "false",
             std::clamp(read_float("autogrind", "start_delta_g", USER_AUTO_GRIND_TRIGGER_DELTA_G),
                        USER_AUTO_GRIND_TRIGGER_MIN_G, USER_AUTO_GRIND_TRIGGER_MAX_G),
             read_bool("autogrind", "auto_return", false) ? "true" : "false",
             purge_mode, purge_amount, freshness, grind_controller_->get_coast_ratio(),
             grind_controller_->get_motor_response_latency(),
             read_bool("logging", "enabled", true) ? "true" : "false",
             read_bool("swipe", "enabled", false) ? "true" : "false",
             static_cast<int>(read_brightness("normal", USER_SCREEN_BRIGHTNESS_NORMAL) * 100.0f + 0.5f),
             static_cast<int>(read_brightness("screensaver", USER_SCREEN_BRIGHTNESS_DIMMED) * 100.0f + 0.5f),
             read_bool("screensaver", "startup", false) ? "true" : "false",
             read_bool("screensaver", "sleep", false) ? "true" : "false",
             screensaver_timing.idle_timeout_s, screensaver_timing.startup_timeout_s,
             screensaver_timing.display_off_enabled ? "true" : "false",
             screensaver_timing.display_off_delay_s,
             screensaver_style.c_str(), LittleFS.exists(BLE_IMAGE_FILENAME) ? "true" : "false",
             gaggimate_host.c_str(),
             read_bool("bluetooth", "startup", true) ? "true" : "false");
    xSemaphoreTake(settings_mutex_, portMAX_DELAY);
    settings_json_cache_ = json;
    xSemaphoreGive(settings_mutex_);
}

void DeviceApi::send_ack(uint32_t client_id, uint32_t request_id, bool has_request_id,
                         const char* action, bool accepted, const char* reason) {
    if (!websocket_.hasClient(client_id) || !websocket_.availableForWrite(client_id)) return;
    char message[192];
    if (has_request_id) {
        snprintf(message, sizeof(message),
                 "{\"api\":\"v1\",\"type\":\"ack\",\"rid\":%lu,\"action\":\"%s\",\"accepted\":%s,\"reason\":\"%s\"}",
                 static_cast<unsigned long>(request_id), action,
                 accepted ? "true" : "false", reason);
    } else {
        snprintf(message, sizeof(message),
                 "{\"api\":\"v1\",\"type\":\"ack\",\"action\":\"%s\",\"accepted\":%s,\"reason\":\"%s\"}",
                 action, accepted ? "true" : "false", reason);
    }
    websocket_.text(client_id, message);
}

void DeviceApi::send_ack(const Command& command, const char* action, bool accepted,
                         const char* reason) {
    send_ack(command.client_id, command.request_id, command.has_request_id,
             action, accepted, reason);
}

String DeviceApi::build_state_message() {
    // Capture profile data before taking controller access; profile persistence
    // must not hold up the motor control loop through a network reader.
    const auto profile = profile_controller_->snapshot();
    const auto control_lock = grind_controller_->lock_control();
    WeightSensor* sensor = hardware_->get_weight_sensor();
    Grinder* grinder = hardware_->get_grinder();
    HallSensor* hall = hardware_->get_hall_sensor();
    const bool idle = grind_controller_->get_phase() == GrindPhase::IDLE;
    const GrindMode mode = idle ? profile.mode : grind_controller_->get_mode();
    const float target_weight = idle ? profile.profiles[profile.current_profile].weight
                                     : grind_controller_->get_target_weight();
    const uint32_t target_time_ms = idle
        ? static_cast<uint32_t>(profile.profiles[profile.current_profile].time_seconds * 1000.0f)
        : grind_controller_->get_target_time_ms();
    // The web metric is for a human-readable live display, so mirror the
    // steadier filtered value used by the on-device UI. The high-frequency raw
    // control samples remain available in the saved session trace.
    const float weight = sensor ? sensor->get_display_weight() : 0.0f;
    const float flow = sensor ? sensor->get_flow_rate() : 0.0f;
    const bool motor_running = grinder && grinder->is_grinding();

    // Knob state — safe to read at any time; HallSensor caches its last reading.
    const float dial = hall ? hall->get_dial_position() : NAN;
    const int32_t raw_adc = hall ? hall->get_raw_adc() : 0;
    const int32_t comp_adc = hall ? hall->get_comp_adc() : 0;
    const float temp_c = hall ? hall->get_chip_temperature() : NAN;
    const bool knob_calibrated = hall && hall->is_calibrated();
    const bool dial_valid = hall && !isnan(dial);

    // Format dial as "null" or a 2-decimal float for the JSON string.
    char dial_str[16];
    if (dial_valid) {
        snprintf(dial_str, sizeof(dial_str), "%.2f", dial);
    } else {
        snprintf(dial_str, sizeof(dial_str), "null");
    }

    char temp_str[16];
    if (!isnan(temp_c)) {
        snprintf(temp_str, sizeof(temp_str), "%.1f", temp_c);
    } else {
        snprintf(temp_str, sizeof(temp_str), "null");
    }

    char message[768];
    snprintf(message, sizeof(message),
             "{\"api\":\"v1\",\"type\":\"state\",\"seq\":%lu,\"timestamp_ms\":%lu,"
             "\"grind\":{\"active\":%s,\"phase\":\"%s\",\"mode\":\"%s\",\"profile\":%d,\"progress\":%d,"
             "\"target_weight\":%.2f,\"target_time_ms\":%lu},"
             "\"scale\":{\"weight\":%.2f,\"flow\":%.2f},"
             "\"motor\":{\"running\":%s},"
             "\"knob\":{\"calibrated\":%s,\"dial\":%s,\"raw_adc\":%ld,\"comp_adc\":%ld,\"temp_c\":%s},"
             "\"system\":{\"free_heap\":%u}}",
             static_cast<unsigned long>(sequence_.fetch_add(1) + 1), static_cast<unsigned long>(millis()),
             grind_controller_->is_active() ? "true" : "false",
             api_phase_name(*grind_controller_),
             mode == GrindMode::TIME ? "time" : mode == GrindMode::MANUAL ? "manual" : "weight",
             idle ? profile.current_profile : grind_controller_->get_session_descriptor().profile_id,
             grind_controller_->get_current_progress_percent(),
             target_weight,
             static_cast<unsigned long>(target_time_ms),
             weight, flow, motor_running ? "true" : "false",
             knob_calibrated ? "true" : "false",
             dial_str,
             static_cast<long>(raw_adc),
             static_cast<long>(comp_adc),
             temp_str,
             static_cast<unsigned int>(ESP.getFreeHeap()));
    return String(message);
}
