PaulT95/smart-grind-by-weight/src/ui/controllers/ready_controller.cpp

#include "ready_controller.h"

#include <Preferences.h>
#include <lvgl.h>
#include "../../config/constants.h"
#include "../../controllers/grind_mode_traits.h"
#include "../event_bridge_lvgl.h"
#include "../ui_manager.h"
#include "../../hardware/HallSensor.h"

ReadyUIController::ReadyUIController(UIManager* manager)
    : ui_manager_(manager) {}

void ReadyUIController::update() {
    const uint32_t now = millis();
    if (!ui_manager_) return;

    if (ui_manager_->state_machine &&
        ui_manager_->state_machine->is_state(UIState::READY) &&
        ui_manager_->current_tab == ReadyScreen::MANUAL_TAB_INDEX &&
        now - last_manual_scale_update_ms_ >= 100) {
        last_manual_scale_update_ms_ = now;
        auto* hardware = ui_manager_->get_hardware_manager();
        auto* sensor = hardware ? hardware->get_weight_sensor() : nullptr;
        const bool available = sensor && !sensor->has_hardware_fault() &&
                               sensor->get_sample_count() > 0;
        ui_manager_->ready_screen.update_manual_scale(
            available ? sensor->get_display_weight() : 0.0f,
            available,
            available && sensor->is_tare_in_progress());
    }

    if (now - last_network_update_ms_ >= 500) {
        last_network_update_ms_ = now;
        ui_manager_->ready_screen.update_network_status();
    }

    if (ui_manager_->state_machine &&
        ui_manager_->state_machine->is_state(UIState::READY) &&
        ui_manager_->current_tab == ReadyScreen::KNOB_TAB_INDEX &&
        now - last_knob_update_ms_ >= 500) {
        last_knob_update_ms_ = now;
        auto* hardware = ui_manager_->get_hardware_manager();
        auto* hall = hardware ? hardware->get_hall_sensor() : nullptr;
        if (hall) {
            int32_t raw = hall->read_raw_adc();
            float dial = hall->calculate_dial(raw);
            ui_manager_->ready_screen.update_grind_knob(dial, raw, hall->is_calibrated());
        }
    }
}

void ReadyUIController::handle_manual_tare() {
    if (!ui_manager_ || !ui_manager_->state_machine ||
        !ui_manager_->state_machine->is_state(UIState::READY) ||
        ui_manager_->current_tab != ReadyScreen::MANUAL_TAB_INDEX) {
        return;
    }

    auto* hardware = ui_manager_->get_hardware_manager();
    auto* sensor = hardware ? hardware->get_weight_sensor() : nullptr;
    if (!sensor || sensor->has_hardware_fault() || sensor->get_sample_count() <= 0 ||
        sensor->is_tare_in_progress()) {
        return;
    }

    sensor->start_nonblocking_tare();
    ui_manager_->ready_screen.update_manual_scale(0.0f, true, true);
    LOG_BLE("Manual page tare requested\n");
}

void ReadyUIController::refresh_profiles() {
    if (!ui_manager_ || !ui_manager_->profile_controller) {
        return;
    }

    float values[USER_PROFILE_COUNT];
    for (int i = 0; i < USER_PROFILE_COUNT; ++i) {
        values[i] = get_profile_target(*ui_manager_->profile_controller, ui_manager_->current_mode, i);
    }
    ui_manager_->ready_screen.update_profile_values(values, ui_manager_->current_mode);
}

void ReadyUIController::handle_tab_change(int tab) {
    if (!ui_manager_) {
        return;
    }

    ui_manager_->current_tab = tab;
    if (tab == ReadyScreen::MANUAL_TAB_INDEX) {
        ui_manager_->current_mode = GrindMode::MANUAL;
        ui_manager_->grinding_screen.set_mode(ui_manager_->current_mode);
    } else if (ui_manager_->profile_controller && ReadyScreen::is_profile_tab(tab)) {
        ui_manager_->profile_controller->set_current_profile(ReadyScreen::profile_index_for_tab(tab));
        ui_manager_->current_mode = ui_manager_->profile_controller->get_grind_mode();
        ui_manager_->grinding_screen.set_mode(ui_manager_->current_mode);
        refresh_profiles();
    } else if (tab == ReadyScreen::KNOB_TAB_INDEX) {
        last_knob_update_ms_ = millis();
        auto* hardware = ui_manager_->get_hardware_manager();
        auto* hall = hardware ? hardware->get_hall_sensor() : nullptr;
        if (hall) {
            int32_t raw = hall->read_raw_adc();
            float dial = hall->calculate_dial(raw);
            ui_manager_->ready_screen.update_grind_knob(dial, raw, hall->is_calibrated());
        }
    }

    if (ui_manager_->grinding_controller_) {
        ui_manager_->grinding_controller_->update_grind_button_icon();
    }
}

void ReadyUIController::handle_profile_long_press() {
    if (!ui_manager_ || !ui_manager_->state_machine) {
        return;
    }

    if (!ui_manager_->state_machine->is_state(UIState::READY) ||
        !ReadyScreen::is_profile_tab(ui_manager_->current_tab)) {
        return;
    }

    ui_manager_->original_target = get_current_profile_target(*ui_manager_->profile_controller, ui_manager_->current_mode);
    ui_manager_->edit_target = ui_manager_->original_target;
    ui_manager_->edit_screen.set_mode(ui_manager_->current_mode);
    if (ui_manager_->edit_controller_) {
        ui_manager_->edit_controller_->update_display();
    }
    ui_manager_->switch_to_state(UIState::EDIT);
}

void ReadyUIController::toggle_mode() {
    if (!ui_manager_ || !ReadyScreen::is_profile_tab(ui_manager_->current_tab)) {
        return;
    }

    Preferences prefs;
    prefs.begin("swipe", true); // read-only
    bool swipe_enabled = prefs.getBool("enabled", false);
    prefs.end();

    if (!swipe_enabled) {
        return;
    }

    ui_manager_->current_mode = (ui_manager_->current_mode == GrindMode::WEIGHT)
                                    ? GrindMode::TIME
                                    : GrindMode::WEIGHT;

    if (ui_manager_->profile_controller) {
        ui_manager_->profile_controller->set_grind_mode(ui_manager_->current_mode);
    }

    refresh_profiles();
    ui_manager_->edit_target = get_current_profile_target(*ui_manager_->profile_controller, ui_manager_->current_mode);
    if (ui_manager_->state_machine && ui_manager_->state_machine->is_state(UIState::EDIT)) {
        if (ui_manager_->edit_controller_) {
            ui_manager_->edit_controller_->update_display();
        }
    }

    ui_manager_->grinding_screen.set_mode(ui_manager_->current_mode);
    if (ui_manager_->state_machine &&
        (ui_manager_->state_machine->is_state(UIState::GRINDING) ||
         ui_manager_->state_machine->is_state(UIState::GRIND_COMPLETE))) {
        if (ui_manager_->grinding_controller_) {
            ui_manager_->grinding_controller_->update_grinding_targets();
        }
    }

    if (ui_manager_->grinding_controller_) {
        ui_manager_->grinding_controller_->update_grind_button_icon();
    }
}

void ReadyUIController::register_events() {
    if (!ui_manager_) {
        return;
    }

    lv_obj_t* ready_screen_obj = ui_manager_->ready_screen.get_screen();
    lv_obj_t* tabview = ui_manager_->ready_screen.get_tabview();

    if (tabview) {
        lv_obj_add_event_cb(tabview, EventBridgeLVGL::dispatch_event, LV_EVENT_VALUE_CHANGED,
                            reinterpret_cast<void*>(static_cast<intptr_t>(EventBridgeLVGL::EventType::TAB_CHANGE)));
    }

    auto gesture_handler = [](lv_event_t* e) {
        if (lv_event_get_code(e) != LV_EVENT_GESTURE) {
            return;
        }
        lv_indev_t* input = lv_indev_get_act();
        lv_dir_t dir = lv_indev_get_gesture_dir(input);
        UIManager* ui = static_cast<UIManager*>(lv_event_get_user_data(e));
        if (!ui || !ui->state_machine->is_state(UIState::READY)) {
            return;
        }

        if ((dir == LV_DIR_LEFT || dir == LV_DIR_RIGHT) && ui->ready_screen.get_tabview()) {
            lv_obj_t* ready_tabs = ui->ready_screen.get_tabview();
            int target_tab = static_cast<int>(lv_tabview_get_tab_act(ready_tabs));
            target_tab += dir == LV_DIR_LEFT ? 1 : -1;
            if (target_tab >= 0 && target_tab < ReadyScreen::TAB_COUNT) {
                lv_tabview_set_act(ready_tabs, static_cast<uint32_t>(target_tab), LV_ANIM_ON);
                lv_indev_wait_release(input);
            }
            lv_event_stop_bubbling(e);
            return;
        }

        if ((dir == LV_DIR_TOP || dir == LV_DIR_BOTTOM) && ui->ready_controller_) {
            ui->ready_controller_->toggle_mode();
            lv_event_stop_bubbling(e);
        }
    };

    if (tabview) {
        lv_obj_add_event_cb(tabview, gesture_handler, LV_EVENT_GESTURE, ui_manager_);
    }
    if (ready_screen_obj) {
        lv_obj_add_event_cb(ready_screen_obj, gesture_handler, LV_EVENT_GESTURE, ui_manager_);
    }
    lv_obj_add_event_cb(lv_scr_act(), gesture_handler, LV_EVENT_GESTURE, ui_manager_);

    EventBridgeLVGL::register_handler(EventBridgeLVGL::EventType::TAB_CHANGE,
                                      [this](lv_event_t* event) {
                                          lv_obj_t* tabview_obj = static_cast<lv_obj_t*>(lv_event_get_target(event));
                                          uint32_t tab_id = lv_tabview_get_tab_act(tabview_obj);
                                          handle_tab_change(static_cast<int>(tab_id));
                                      });

    EventBridgeLVGL::register_handler(EventBridgeLVGL::EventType::PROFILE_LONG_PRESS,
                                      [this](lv_event_t*) { handle_profile_long_press(); });

    EventBridgeLVGL::register_handler(EventBridgeLVGL::EventType::MANUAL_TARE,
                                      [this](lv_event_t*) { handle_manual_tare(); });

    ui_manager_->ready_screen.set_profile_long_press_handler(EventBridgeLVGL::profile_long_press_handler);
    ui_manager_->ready_screen.set_manual_tare_handler(EventBridgeLVGL::dispatch_event);

}
