PaulT95/smart-grind-by-weight/src/ui/controllers/menu_controller.h

#pragma once
#include <lvgl.h>
#include "../../system/operation_interlock.h"

class UIManager;

// Handles the interactive menu: BLE/logging toggles, brightness sliders, maintenance actions, and stats

class MenuUIController {
public:
    explicit MenuUIController(UIManager* manager);

    void register_events();
    void update();
    void handle_calibrate();
    void handle_reset();
    void handle_purge();
    void handle_motor_test();
    void handle_scale_open();
    void handle_scale_tare();
    void handle_hall_cal_record_point(lv_event_t* e);
    void handle_hall_cal_clear();
    void handle_hall_drift_toggle();
    void handle_hall_drift_cal_start();
    void handle_hall_drift_cal_finish();
    void handle_hall_drift_cal_cancel();
    void handle_autotune();
    void handle_back();
    void handle_refresh_stats();
    void handle_install_update();
    void handle_diagnostics_reset();
    void handle_ble_toggle();
    void handle_ble_startup_toggle();
    void handle_logging_toggle();
    void handle_grind_mode_swipe_toggle();
    void handle_grind_mode_radio_button();
    void handle_auto_start_toggle();
    void handle_auto_start_threshold_slider();
    void handle_auto_start_threshold_slider_released();
    void handle_auto_return_toggle();
    void handle_grinder_purge_mode_radio_button();
    void handle_grinder_purge_amount_slider();
    void handle_grinder_purge_amount_slider_released();
    void handle_grind_freshness_hours_slider();
    void handle_grind_freshness_hours_slider_released();
    void handle_coast_ratio_slider();
    void handle_coast_ratio_slider_released();
    void handle_motor_latency_slider();
    void handle_motor_latency_slider_released();
    void handle_brightness_normal_slider();
    void handle_brightness_normal_slider_released();
    void handle_brightness_screensaver_slider();
    void handle_brightness_screensaver_slider_released();
    void handle_screensaver_startup_toggle();
    void handle_screensaver_sleep_toggle();
    void handle_display_off_toggle();

    float get_normal_brightness() const;
    float get_screensaver_brightness() const;

private:
    UIManager* ui_manager_;
    lv_timer_t* motor_timer_{};
    OperationInterlock::Token motor_test_token_ = 0;
    uint32_t last_status_update_ms_ = 0;

    void perform_factory_reset();
    void execute_purge_operation();
    void run_motor_test();
    void stop_motor_timer();
    void motor_timer_cb(lv_timer_t* timer);
    static void static_motor_timer_cb(lv_timer_t* timer);
    void return_to_menu();
    void perform_diagnostics_reset();
};
