PaulT95/smart-grind-by-weight/src/ui/screens/menu_screen.cpp

#include "menu_screen.h"
#include "../../config/build_info.h"
#include <Arduino.h>
#include <algorithm>
#include <LittleFS.h>
#include <Preferences.h>
#include <WiFi.h>
#include "../../config/constants.h"
#include "../../logging/grind_logging.h"
#include "../../system/statistics_manager.h"
#include "../../system/screensaver_settings.h"
#include "../../hardware/hardware_manager.h"
#include "../../hardware/HallSensor.h"
#include "../../network/network_manager.h"
#include "../../network/provisioning_service.h"
#include "../../network/device_web_server.h"
#include "grinding_screen.h"
#include "../event_bridge_lvgl.h"
#include "../../config/logging.h"
#include "../components/blocking_overlay.h"

static void back_event_handler(lv_event_t * e)
{
    lv_obj_t * obj = lv_event_get_target_obj(e);
    lv_obj_t * menu = (lv_obj_t *)lv_event_get_user_data(e);

    if(lv_menu_back_button_is_root(menu, obj)) {
        // Call the EventBridge handle_event directly with MENU_BACK event
        EventBridgeLVGL::handle_event(EventBridgeLVGL::EventType::MENU_BACK, e);
    }
}

void MenuScreen::create(BluetoothManager* bluetooth, GrindController* grind_ctrl, GrindingScreen* grind_screen, class HardwareManager* hw_mgr, DiagnosticsController* diag_ctrl) {
    bluetooth_manager = bluetooth;
    grind_controller = grind_ctrl;
    grinding_screen = grind_screen;
    hardware_manager = hw_mgr;
    diagnostics_controller = diag_ctrl;

    screen = lv_obj_create(lv_scr_act());
    lv_obj_set_size(screen, LV_PCT(100), LV_PCT(100));
    lv_obj_align(screen, LV_ALIGN_TOP_MID, 0, 0);
    lv_obj_set_style_bg_opa(screen, LV_OPA_TRANSP, 0);
    lv_obj_set_style_border_width(screen, 0, 0);
    lv_obj_set_style_pad_all(screen, 0, 0);

    visible = false;
    scale_active = false;
    scale_page = nullptr;
    scale_weight_label = nullptr;
    scale_tare_button = nullptr;
    scale_item = nullptr;
    grind_knob_active = false;
    grind_knob_page = nullptr;
    grind_knob_item = nullptr;
    knob_dial_label = nullptr;
    knob_adc_label = nullptr;
    knob_comp_adc_label = nullptr;
    knob_temp_label = nullptr;
    knob_clear_button = nullptr;
    knob_temp_comp_toggle = nullptr;
    knob_drift_coeff_label = nullptr;
    knob_drift_ref_label = nullptr;
    knob_drift_cal_button = nullptr;
    knob_drift_cal_container = nullptr;
    knob_drift_status_label = nullptr;
    knob_drift_detail_label = nullptr;
    knob_drift_save_button = nullptr;
    knob_drift_cancel_button = nullptr;
    for (int i = 0; i < HW_HALL_NUM_CAL_POINTS; i++) {
        knob_cal_status_labels[i] = nullptr;
        knob_cal_read_buttons[i] = nullptr;
    }
    network_page = nullptr;
    network_status_label = nullptr;
    network_detail_label = nullptr;
    network_qr = nullptr;
    network_update_label = nullptr;
    network_update_button = nullptr;
    network_status_text.clear();
    network_detail_text.clear();
    network_qr_payload.clear();
    network_update_text.clear();
    network_update_button_visible = false;
    grinder_purge_mode_radio_group = nullptr;
    grinder_purge_amount_slider = nullptr;
    grinder_purge_amount_label = nullptr;
    grind_freshness_hours_slider = nullptr;
    grind_freshness_hours_label = nullptr;
    coast_ratio_slider = nullptr;
    coast_ratio_label = nullptr;
    motor_latency_slider = nullptr;
    motor_latency_label = nullptr;
    auto_start_threshold_slider = nullptr;
    auto_start_threshold_label = nullptr;
    display_off_toggle = nullptr;
    lv_obj_add_flag(screen, LV_OBJ_FLAG_HIDDEN);

    // Create menu UI immediately at boot for instant access
    create_menu_ui();
}

void MenuScreen::create_menu_ui() {
    if (menu) {
        return; // Already created
    }

    LOG_BLE("[%lums MENU] Creating menu UI\n", millis());

    // Create menu instead of tabview
    menu = lv_menu_create(screen);
    lv_obj_set_size(menu, LV_PCT(100), LV_PCT(100));
    lv_obj_align(menu, LV_ALIGN_TOP_MID, 0, 0);
    lv_obj_set_style_bg_opa(menu, LV_OPA_TRANSP, 0);
    lv_obj_set_style_pad_all(menu, 0, 0);
    lv_menu_set_mode_root_back_button(menu, LV_MENU_ROOT_BACK_BUTTON_ENABLED);
    lv_obj_add_event_cb(menu, back_event_handler, LV_EVENT_CLICKED, menu);

    // Get header and set up flex layout
    lv_obj_t* header = lv_menu_get_main_header(menu);
    lv_obj_set_layout(header, LV_LAYOUT_FLEX);
    lv_obj_set_flex_flow(header, LV_FLEX_FLOW_ROW);
    lv_obj_set_flex_align(header, LV_FLEX_ALIGN_SPACE_BETWEEN, LV_FLEX_ALIGN_CENTER, LV_FLEX_ALIGN_CENTER);
    lv_coord_t title_base_height = lv_font_get_line_height(&lv_font_montserrat_36);
    lv_coord_t title_target_height = (title_base_height * 3) / 2; // ~50% taller
    lv_coord_t title_padding = (title_target_height - title_base_height) / 2;
    lv_obj_set_style_min_height(header, title_target_height, 0);
    lv_obj_set_style_pad_top(header, title_padding, 0);
    lv_obj_set_style_pad_bottom(header, title_padding, 0);

    // Get the header label
    lv_obj_t* header_label = lv_obj_get_child(header, -1);
    if (header_label) {
        lv_obj_set_style_text_align(header_label, LV_TEXT_ALIGN_CENTER, 0);
        lv_obj_set_style_text_font(header_label, &lv_font_montserrat_36, 0);
        lv_obj_set_style_text_color(header_label, lv_color_hex(THEME_COLOR_TEXT_SECONDARY), 0);
        lv_obj_set_style_min_height(header_label, title_target_height, 0);
        lv_obj_set_style_pad_top(header_label, title_padding, 0);
        lv_obj_set_style_pad_bottom(header_label, title_padding, 0);
    }
    // Get and style the chevron first
    lv_obj_t* back_chevron = lv_menu_get_main_header_back_button(menu);
    lv_obj_set_style_text_font(back_chevron, &lv_font_montserrat_32, 0);
    lv_obj_set_ext_click_area(back_chevron, 200);
    lv_obj_set_style_text_color(back_chevron, lv_color_hex(THEME_COLOR_TEXT_SECONDARY), 0);
    lv_obj_set_style_min_height(back_chevron, title_target_height, 0);
    lv_obj_set_style_pad_top(back_chevron, title_padding, 0);
    lv_obj_set_style_pad_bottom(back_chevron, title_padding, 0);

    // Force layout update to get proper chevron dimensions
    lv_obj_update_layout(header);

    // Create spacer using chevron's actual size
    // Spacer is used to center name of the page name in the header
    lv_obj_t* spacer = lv_obj_create(header);
    lv_obj_set_size(spacer, lv_obj_get_width(back_chevron), lv_obj_get_height(back_chevron));
    lv_obj_set_style_bg_opa(spacer, LV_OPA_TRANSP, 0);
    lv_obj_set_style_border_width(spacer, 0, 0);
    lv_obj_clear_flag(spacer, LV_OBJ_FLAG_SCROLLABLE);

    // Create main page last
    lv_obj_t* main_page = lv_menu_page_create(menu, "Menu");
    lv_obj_set_layout(main_page, LV_LAYOUT_FLEX);
    lv_obj_set_flex_flow(main_page, LV_FLEX_FLOW_COLUMN);
    lv_obj_set_style_pad_all(main_page, 0, 0);
    lv_obj_set_style_pad_gap(main_page, 0, 0);
    lv_obj_set_scroll_dir(main_page, LV_DIR_VER);
    lv_obj_set_scrollbar_mode(main_page, LV_SCROLLBAR_MODE_AUTO);

    // Create sub-pages with titles
    info_page = lv_menu_page_create(menu, "Info");
    create_info_page(info_page);

    bluetooth_page = lv_menu_page_create(menu, "Bluetooth");
    create_bluetooth_page(bluetooth_page);

    network_page = lv_menu_page_create(menu, "Wi-Fi");
    create_network_page(network_page);

    display_page = lv_menu_page_create(menu, "Display");
    create_display_page(display_page);
    
    grind_mode_page = lv_menu_page_create(menu, "Grind Settings");
    create_grind_mode_page(grind_mode_page);
    
    scale_page = lv_menu_page_create(menu, "Scale");
    create_scale_page(scale_page);

    grind_knob_page = lv_menu_page_create(menu, "Grind Knob");
    create_grind_knob_page(grind_knob_page);

    data_page = lv_menu_page_create(menu, "Logs & Data");
    create_data_page(data_page);

    stats_page = lv_menu_page_create(menu, "Lifetime Stats");
    create_stats_page(stats_page);

    diagnostics_page = lv_menu_page_create(menu, "Diagnostics");
    create_diagnostics_page(diagnostics_page);

    // Create menu items grouped with separators
    create_separator(main_page, "Tools");
    scale_item = create_menu_item(main_page, "Scale");
    grind_knob_item = create_menu_item(main_page, "Grind Knob");
    cal_button = create_menu_item(main_page, "Calibrate");
    autotune_button = create_menu_item(main_page, "Tune Pulses");
    motor_test_button = create_menu_item(main_page, "Motor Test");

    lv_menu_set_load_page_event(menu, scale_item, scale_page);
    lv_menu_set_load_page_event(menu, grind_knob_item, grind_knob_page);

    lv_obj_add_flag(scale_item, LV_OBJ_FLAG_CLICKABLE);
    lv_obj_add_flag(grind_knob_item, LV_OBJ_FLAG_CLICKABLE);
    lv_obj_add_flag(cal_button, LV_OBJ_FLAG_CLICKABLE);
    lv_obj_add_flag(autotune_button, LV_OBJ_FLAG_CLICKABLE);
    lv_obj_add_flag(motor_test_button, LV_OBJ_FLAG_CLICKABLE);

    using ET = EventBridgeLVGL::EventType;
    if (cal_button) {
        lv_obj_add_event_cb(cal_button, EventBridgeLVGL::dispatch_event, LV_EVENT_CLICKED,
                           reinterpret_cast<void*>(static_cast<intptr_t>(ET::MENU_CALIBRATE)));
    }
    if (autotune_button) {
        lv_obj_add_event_cb(autotune_button, EventBridgeLVGL::dispatch_event, LV_EVENT_CLICKED,
                           reinterpret_cast<void*>(static_cast<intptr_t>(ET::MENU_AUTOTUNE)));
    }
    if (motor_test_button) {
        lv_obj_add_event_cb(motor_test_button, EventBridgeLVGL::dispatch_event, LV_EVENT_CLICKED,
                           reinterpret_cast<void*>(static_cast<intptr_t>(ET::MENU_MOTOR_TEST)));
    }

    create_separator(main_page, "Settings");
    lv_obj_t* bluetooth_item = create_menu_item(main_page, "Bluetooth");
    lv_menu_set_load_page_event(menu, bluetooth_item, bluetooth_page);

    lv_obj_t* network_item = create_menu_item(main_page, "Wi-Fi");
    lv_menu_set_load_page_event(menu, network_item, network_page);

    lv_obj_t* display_item = create_menu_item(main_page, "Display");
    lv_menu_set_load_page_event(menu, display_item, display_page);

    lv_obj_t* grind_mode_item = create_menu_item(main_page, "Grind Settings");
    lv_menu_set_load_page_event(menu, grind_mode_item, grind_mode_page);

    create_separator(main_page, "Info");
    lv_obj_t* diagnostics_item = create_menu_item(main_page, "Diagnostics");
    lv_menu_set_load_page_event(menu, diagnostics_item, diagnostics_page);

    lv_obj_t* info_item = create_menu_item(main_page, "System Info");
    lv_menu_set_load_page_event(menu, info_item, info_page);

    lv_obj_t* data_item = create_menu_item(main_page, "Logs & Data");
    lv_menu_set_load_page_event(menu, data_item, data_page);

    lv_obj_t* stats_item = create_menu_item(main_page, "Lifetime Stats");
    lv_menu_set_load_page_event(menu, stats_item, stats_page);

    // Set main page as active (menu will be the landing page)
    lv_menu_set_page(menu, main_page);

    // Refresh lifetime/log statistics whenever the Data or Stats page is displayed
    auto changing_page_callback = [](lv_event_t * e) {
        MenuScreen * self = static_cast<MenuScreen*>(lv_event_get_user_data(e));
        lv_obj_t * menu = static_cast<lv_obj_t *>(lv_event_get_target(e));
        lv_obj_t * cur = lv_menu_get_cur_main_page(menu);
        if (cur == self->data_page || cur == self->stats_page) {
            self->refresh_statistics();
        }

        bool on_scale = (cur == self->scale_page);
        if (on_scale) {
            if (!self->scale_active) {
                self->scale_active = true;
                self->reset_scale_display();
                EventBridgeLVGL::handle_event(EventBridgeLVGL::EventType::MENU_SCALE_OPEN, e);
            }
        } else if (self->scale_active) {
            self->scale_active = false;
        }

        bool on_grind_knob = (cur == self->grind_knob_page);
        if (on_grind_knob) {
            if (!self->grind_knob_active) {
                self->grind_knob_active = true;
                if (self->hardware_manager) {
                    self->update_hall_calibration_display(self->hardware_manager->get_hall_sensor());
                    self->update_drift_compensation_display(self->hardware_manager->get_hall_sensor());
                }
            }
        } else if (self->grind_knob_active) {
            self->grind_knob_active = false;
        }
    };

    lv_obj_add_event_cb(menu, changing_page_callback, LV_EVENT_VALUE_CHANGED, this);

    LOG_BLE("[%lums MENU] Menu UI created successfully\n", millis());
}

void MenuScreen::create_info_page(lv_obj_t* parent) {
    lv_obj_set_layout(parent, LV_LAYOUT_FLEX);
    lv_obj_set_flex_flow(parent, LV_FLEX_FLOW_COLUMN);
    lv_obj_set_flex_align(parent, LV_FLEX_ALIGN_START, LV_FLEX_ALIGN_CENTER, LV_FLEX_ALIGN_CENTER);
    lv_obj_set_style_pad_all(parent, 0, 0);
    
    // Enable vertical scrolling for the info page content
    lv_obj_set_scroll_dir(parent, LV_DIR_VER);
    lv_obj_set_scrollbar_mode(parent, LV_SCROLLBAR_MODE_AUTO);

    char build_info[64];
    snprintf(build_info, sizeof(build_info), "#%d", BUILD_NUMBER);

    create_description_label(parent, "Device metrics and current status snapshot.");

    create_static_data_label(parent, "Firmware:", "v" BUILD_FIRMWARE_VERSION);
    create_static_data_label(parent, "Build:", build_info);    
    
    create_separator(parent);
    
    create_data_label(parent, "Instant:", &instant_label);
    create_data_label(parent, "Samples:", &samples_label);
    create_data_label(parent, "Raw:", &raw_label);

    create_separator(parent);
   
    create_data_label(parent, "Uptime:", &uptime_label);
    create_data_label(parent, "RAM:", &memory_label);
}


void MenuScreen::create_bluetooth_page(lv_obj_t* parent) {
    lv_obj_set_layout(parent, LV_LAYOUT_FLEX);
    lv_obj_set_flex_flow(parent, LV_FLEX_FLOW_COLUMN);
    lv_obj_set_flex_align(parent, LV_FLEX_ALIGN_START, LV_FLEX_ALIGN_CENTER, LV_FLEX_ALIGN_CENTER);

    // Enable vertical scrolling on the menu page
    lv_obj_set_scroll_dir(parent, LV_DIR_VER);
    lv_obj_set_scrollbar_mode(parent, LV_SCROLLBAR_MODE_AUTO);

    create_toggle_row(parent, "Enabled", &ble_toggle);
    create_toggle_row(parent, "Startup", &ble_startup_toggle);

    // BLE Status label
    ble_status_label = lv_label_create(parent);
    lv_label_set_text(ble_status_label, "Bluetooth: Disabled");
    lv_obj_set_style_text_font(ble_status_label, &lv_font_montserrat_24, 0);
    lv_obj_set_style_text_color(ble_status_label, lv_color_hex(THEME_COLOR_TEXT_SECONDARY), 0);
    lv_obj_clear_flag(ble_status_label, LV_OBJ_FLAG_SCROLLABLE);

    // BLE Timer label
    ble_timer_label = lv_label_create(parent);
    lv_label_set_text(ble_timer_label, "");
    lv_obj_set_style_text_font(ble_timer_label, &lv_font_montserrat_24, 0);
    lv_obj_set_style_text_color(ble_timer_label, lv_color_hex(THEME_COLOR_WARNING), 0);
    lv_obj_clear_flag(ble_timer_label, LV_OBJ_FLAG_SCROLLABLE);

    // Register events for the toggles (done here because widgets are created lazily)
    using ET = EventBridgeLVGL::EventType;
    if (ble_toggle) {
        lv_obj_add_event_cb(ble_toggle, EventBridgeLVGL::dispatch_event, LV_EVENT_VALUE_CHANGED,
                           reinterpret_cast<void*>(static_cast<intptr_t>(ET::BLE_TOGGLE)));
    }
    if (ble_startup_toggle) {
        lv_obj_add_event_cb(ble_startup_toggle, EventBridgeLVGL::dispatch_event, LV_EVENT_VALUE_CHANGED,
                           reinterpret_cast<void*>(static_cast<intptr_t>(ET::BLE_STARTUP_TOGGLE)));
    }
}

namespace {
String escape_wifi_qr_value(const String& value) {
    String escaped;
    escaped.reserve(value.length() + 8);
    for (size_t i = 0; i < value.length(); ++i) {
        const char ch = value[i];
        if (ch == '\\' || ch == ';' || ch == ',' || ch == ':' || ch == '"') escaped += '\\';
        escaped += ch;
    }
    return escaped;
}
}

void MenuScreen::create_network_page(lv_obj_t* parent) {
    lv_obj_set_layout(parent, LV_LAYOUT_FLEX);
    lv_obj_set_flex_flow(parent, LV_FLEX_FLOW_COLUMN);
    lv_obj_set_flex_align(parent, LV_FLEX_ALIGN_START, LV_FLEX_ALIGN_CENTER, LV_FLEX_ALIGN_CENTER);
    lv_obj_set_scroll_dir(parent, LV_DIR_VER);
    lv_obj_set_scrollbar_mode(parent, LV_SCROLLBAR_MODE_AUTO);

    network_status_label = lv_label_create(parent);
    lv_obj_set_style_text_font(network_status_label, &lv_font_montserrat_24, 0);
    lv_obj_set_style_text_color(network_status_label, lv_color_hex(THEME_COLOR_TEXT_SECONDARY), 0);

    network_detail_label = lv_label_create(parent);
    lv_obj_set_width(network_detail_label, LV_PCT(90));
    lv_label_set_long_mode(network_detail_label, LV_LABEL_LONG_WRAP);
    lv_obj_set_style_text_align(network_detail_label, LV_TEXT_ALIGN_CENTER, 0);
    lv_obj_set_style_text_font(network_detail_label, &lv_font_montserrat_16, 0);
    lv_obj_set_style_text_color(network_detail_label, lv_color_hex(THEME_COLOR_TEXT_SECONDARY), 0);

    network_qr = lv_qrcode_create(parent);
    lv_qrcode_set_size(network_qr, 180);
    lv_qrcode_set_dark_color(network_qr, lv_color_hex(0x000000));
    lv_qrcode_set_light_color(network_qr, lv_color_hex(0xFFFFFF));
    lv_qrcode_set_quiet_zone(network_qr, true);
    lv_obj_add_flag(network_qr, LV_OBJ_FLAG_HIDDEN);

    network_update_label = lv_label_create(parent);
    lv_label_set_text(network_update_label, "");
    lv_obj_set_width(network_update_label, LV_PCT(90));
    lv_label_set_long_mode(network_update_label, LV_LABEL_LONG_WRAP);
    lv_obj_set_style_text_align(network_update_label, LV_TEXT_ALIGN_CENTER, 0);
    lv_obj_set_style_text_font(network_update_label, &lv_font_montserrat_24, 0);
    lv_obj_set_style_text_color(network_update_label, lv_color_hex(THEME_COLOR_TEXT_SECONDARY), 0);
    lv_obj_add_flag(network_update_label, LV_OBJ_FLAG_HIDDEN);

    network_update_button = create_button(parent, LV_SYMBOL_REFRESH "  INSTALL UPDATE",
                                          lv_color_hex(THEME_COLOR_SUCCESS), 260, 72,
                                          &lv_font_montserrat_24);
    lv_obj_add_event_cb(
        network_update_button, EventBridgeLVGL::dispatch_event, LV_EVENT_CLICKED,
        reinterpret_cast<void*>(static_cast<intptr_t>(EventBridgeLVGL::EventType::MENU_INSTALL_UPDATE)));
    lv_obj_add_flag(network_update_button, LV_OBJ_FLAG_HIDDEN);

    update_network_status();
}

void MenuScreen::update_network_status() {
    if (!network_status_label || !network_detail_label || !network_qr ||
        !network_update_label || !network_update_button) return;

    String status;
    String detail;
    String qr_payload;
    switch (network_manager.state()) {
        case NetworkState::WIFI_DISABLED:
            status = "Wi-Fi disabled";
            detail = "Wi-Fi can be enabled after setup support is complete.";
            break;
        case NetworkState::WIFI_NO_CREDENTIALS:
        case NetworkState::WIFI_SETUP_REQUIRED:
            status = "Starting setup";
            detail = "Preparing a secure setup network...";
            break;
        case NetworkState::WIFI_CONNECTING:
            status = "Connecting";
            detail = network_manager.network_name();
            break;
        case NetworkState::WIFI_CONNECTED:
            if (device_web_server.is_ota_active()) {
                status = "Updating firmware";
                detail = String(device_web_server.ota_progress_percent()) + "% received\nDo not remove power.";
            } else {
                status = "Connected";
                detail = network_manager.network_name() + "\nhttp://" + network_manager.hostname() + ".local\n" + network_manager.ip_address();
            }
            break;
        case NetworkState::WIFI_RETRY_WAIT:
            status = "Connection lost";
            detail = "Will retry automatically.";
            break;
        case NetworkState::WIFI_SETUP_AP: {
            status = "Wi-Fi setup";
            const String& ssid = provisioning_service.access_point_ssid();
            const String& password = provisioning_service.access_point_password();
            detail = "Scan to join\n" + ssid + "\nPassword: " + password +
                     "\nthen use the sign-in page or open " + WiFi.softAPIP().toString();
            qr_payload = "WIFI:T:";
            qr_payload += password.isEmpty() ? "nopass" : "WPA";
            qr_payload += ";S:" + escape_wifi_qr_value(ssid);
            if (!password.isEmpty()) qr_payload += ";P:" + escape_wifi_qr_value(password);
            qr_payload += ";;";
            break;
        }
    }

    if (status != network_status_text) {
        lv_label_set_text(network_status_label, status.c_str());
        network_status_text = status;
    }
    if (detail != network_detail_text) {
        lv_label_set_text(network_detail_label, detail.c_str());
        network_detail_text = detail;
    }
    if (qr_payload.isEmpty()) {
        lv_obj_add_flag(network_qr, LV_OBJ_FLAG_HIDDEN);
    } else {
        if (qr_payload != network_qr_payload) {
            lv_qrcode_update(network_qr, qr_payload.c_str(), qr_payload.length());
            network_qr_payload = qr_payload;
        }
        lv_obj_clear_flag(network_qr, LV_OBJ_FLAG_HIDDEN);
    }

    String update_text;
    bool show_update_button = false;
    if (network_manager.state() == NetworkState::WIFI_CONNECTED) {
        switch (device_web_server.firmware_update_state()) {
            case FirmwareUpdateState::UNKNOWN:
                update_text = "Update check will run while idle.";
                break;
            case FirmwareUpdateState::CHECKING:
                update_text = "Checking for updates...";
                break;
            case FirmwareUpdateState::CURRENT:
                update_text = "Firmware is up to date.";
                break;
            case FirmwareUpdateState::AVAILABLE:
                update_text = device_web_server.latest_release_tag() + " is ready to install.";
                show_update_button = true;
                break;
            case FirmwareUpdateState::FAILED:
                update_text = "Update check unavailable; it will retry.";
                break;
        }
    }
    if (update_text != network_update_text) {
        network_update_text = update_text;
        lv_label_set_text(network_update_label, update_text.c_str());
        if (update_text.isEmpty()) {
            lv_obj_add_flag(network_update_label, LV_OBJ_FLAG_HIDDEN);
        } else {
            lv_obj_clear_flag(network_update_label, LV_OBJ_FLAG_HIDDEN);
        }
    }
    if (show_update_button != network_update_button_visible) {
        network_update_button_visible = show_update_button;
        if (show_update_button) {
            lv_obj_clear_flag(network_update_button, LV_OBJ_FLAG_HIDDEN);
        } else {
            lv_obj_add_flag(network_update_button, LV_OBJ_FLAG_HIDDEN);
        }
    }

}

void MenuScreen::create_display_page(lv_obj_t* parent) {
    lv_obj_set_layout(parent, LV_LAYOUT_FLEX);
    lv_obj_set_flex_flow(parent, LV_FLEX_FLOW_COLUMN);
    lv_obj_set_flex_align(parent, LV_FLEX_ALIGN_START, LV_FLEX_ALIGN_CENTER, LV_FLEX_ALIGN_CENTER);
    // Enable vertical scrolling on the menu page
    lv_obj_set_scroll_dir(parent, LV_DIR_VER);
    lv_obj_set_scrollbar_mode(parent, LV_SCROLLBAR_MODE_AUTO);

    create_slider_row(parent, "Brightness", &brightness_normal_label, &brightness_normal_slider);
    create_slider_row(parent, "Screensaver", &brightness_screensaver_label, &brightness_screensaver_slider, lv_color_hex(THEME_COLOR_WARNING));

    // Register events for the sliders (done here because widgets are created lazily)
    using ET = EventBridgeLVGL::EventType;
    if (brightness_normal_slider) {
        lv_obj_add_event_cb(brightness_normal_slider, EventBridgeLVGL::dispatch_event, LV_EVENT_VALUE_CHANGED,
                           reinterpret_cast<void*>(static_cast<intptr_t>(ET::BRIGHTNESS_NORMAL_SLIDER)));
        lv_obj_add_event_cb(brightness_normal_slider, EventBridgeLVGL::dispatch_event, LV_EVENT_RELEASED,
                           reinterpret_cast<void*>(static_cast<intptr_t>(ET::BRIGHTNESS_NORMAL_SLIDER_RELEASED)));
    }
    if (brightness_screensaver_slider) {
        lv_obj_add_event_cb(brightness_screensaver_slider, EventBridgeLVGL::dispatch_event, LV_EVENT_VALUE_CHANGED,
                           reinterpret_cast<void*>(static_cast<intptr_t>(ET::BRIGHTNESS_SCREENSAVER_SLIDER)));
        lv_obj_add_event_cb(brightness_screensaver_slider, EventBridgeLVGL::dispatch_event, LV_EVENT_RELEASED,
                           reinterpret_cast<void*>(static_cast<intptr_t>(ET::BRIGHTNESS_SCREENSAVER_SLIDER_RELEASED)));
    }

    // Custom screensaver image toggles
    create_separator(parent, "Custom Image");
    create_description_label(parent, "Show uploaded image on startup or when display dims.");
    create_toggle_row(parent, "Startup", &screensaver_startup_toggle);
    create_toggle_row(parent, "Idle Screensaver", &screensaver_sleep_toggle);
    create_toggle_row(parent, "Turn Display Off", &display_off_toggle);

    if (screensaver_startup_toggle) {
        lv_obj_add_event_cb(screensaver_startup_toggle, EventBridgeLVGL::dispatch_event, LV_EVENT_VALUE_CHANGED,
                           reinterpret_cast<void*>(static_cast<intptr_t>(ET::SCREENSAVER_STARTUP_TOGGLE)));
    }
    if (screensaver_sleep_toggle) {
        lv_obj_add_event_cb(screensaver_sleep_toggle, EventBridgeLVGL::dispatch_event, LV_EVENT_VALUE_CHANGED,
                           reinterpret_cast<void*>(static_cast<intptr_t>(ET::SCREENSAVER_SLEEP_TOGGLE)));
    }
    if (display_off_toggle) {
        lv_obj_add_event_cb(display_off_toggle, EventBridgeLVGL::dispatch_event, LV_EVENT_VALUE_CHANGED,
                           reinterpret_cast<void*>(static_cast<intptr_t>(ET::DISPLAY_OFF_TOGGLE)));
    }

}


// Callback for grind mode radio button selection
static void grind_mode_callback(int selected_index, void* user_data) {
    // Trigger the event system instead of handling directly
    EventBridgeLVGL::handle_event(EventBridgeLVGL::EventType::GRIND_MODE_RADIO_BUTTON, nullptr);
}

// Callback for grinder purge mode radio button selection
static void grinder_purge_mode_callback(int selected_index, void* user_data) {
    // Trigger the event system instead of handling directly
    EventBridgeLVGL::handle_event(EventBridgeLVGL::EventType::GRINDER_PURGE_MODE_RADIO_BUTTON, nullptr);
}

void MenuScreen::create_grind_mode_page(lv_obj_t* parent) {
    lv_obj_set_layout(parent, LV_LAYOUT_FLEX);
    lv_obj_set_flex_flow(parent, LV_FLEX_FLOW_COLUMN);
    lv_obj_set_flex_align(parent, LV_FLEX_ALIGN_START, LV_FLEX_ALIGN_CENTER, LV_FLEX_ALIGN_CENTER);

    // Enable vertical scrolling on the grind mode page
    lv_obj_set_scroll_dir(parent, LV_DIR_VER);
    lv_obj_set_scrollbar_mode(parent, LV_SCROLLBAR_MODE_AUTO);

    // Mode Selection separator/label
    create_separator(parent, "Mode Selection");

    // Radio button group for grind mode selection at top
    const char* grind_modes[] = {"Weight", "Time"};
    grind_mode_radio_group = create_radio_button_group(
        parent,
        grind_modes,
        2,
        LV_FLEX_FLOW_ROW,
        0,  // Weight initially selected
        135, 100,  // Width, Height
        grind_mode_callback,
        this
    );

    // Descriptive label for swipe functionality
    lv_obj_t* swipe_desc_label = lv_label_create(parent);
    lv_label_set_text(swipe_desc_label, "Enable swiping vertically to switch between Weight/Time modes");
    lv_obj_set_style_text_font(swipe_desc_label, &lv_font_montserrat_24, 0);
    lv_obj_set_style_text_color(swipe_desc_label, lv_color_hex(THEME_COLOR_TEXT_SECONDARY), 0);
    lv_obj_set_style_margin_bottom(swipe_desc_label, 10, 0);
    lv_label_set_long_mode(swipe_desc_label, LV_LABEL_LONG_WRAP);
    lv_obj_set_width(swipe_desc_label, 260);

    // Swipe toggle using existing pattern
    create_toggle_row(parent, "Swipe", &grind_mode_swipe_toggle);

    // Automatic actions section
    create_separator(parent, "Automation");
    create_description_label(parent, "Start the selected profile as soon as the cup lands on the scale.");
    create_toggle_row(parent, "Start", &auto_start_toggle);
    const uint32_t auto_start_min = static_cast<uint32_t>(USER_AUTO_GRIND_TRIGGER_MIN_G * kAutoStartThresholdSliderScale + 0.5f);
    const uint32_t auto_start_max = static_cast<uint32_t>(USER_AUTO_GRIND_TRIGGER_MAX_G * kAutoStartThresholdSliderScale + 0.5f);
    create_slider_row(parent, "Cup threshold", &auto_start_threshold_label,
                      &auto_start_threshold_slider, lv_color_hex(THEME_COLOR_ACCENT),
                      auto_start_min, auto_start_max);
    create_description_label(parent, "Use a value below the empty cup or portafilter weight to prevent accidental starts.");
    create_description_label(parent, "Exit the completion screen once that cup weight drops away.");
    create_toggle_row(parent, "Return", &auto_return_toggle);

    // Grinder Purging section
    create_separator(parent, "Purging");
    create_description_label(parent, "Decide what do do with the grinded coffee after the grinder is primed.");

    // Radio button group for grinder purge mode (Keep/Remove)
    const char* grinder_purge_modes[] = {"Keep", "Remove"};
    grinder_purge_mode_radio_group = create_radio_button_group(
        parent,
        grinder_purge_modes,
        2,
        LV_FLEX_FLOW_ROW,
        1,  // Purge initially selected (index 1)
        135, 100,  // Width, Height
        grinder_purge_mode_callback,
        this
    );

    create_description_label(parent, "Purge amount is a minimum target, not an exact goal.");

    // Slider for grinder purge amount (uses kPurgeSliderScale for resolution)
    const uint32_t slider_min_units = static_cast<uint32_t>(GRIND_PURGE_AMOUNT_MIN_G * kPurgeSliderScale + 0.5f);
    const uint32_t slider_max_units = static_cast<uint32_t>(GRIND_PURGE_AMOUNT_MAX_G * kPurgeSliderScale + 0.5f);
    create_slider_row(parent, "Amount", &grinder_purge_amount_label, &grinder_purge_amount_slider,
                     lv_color_hex(THEME_COLOR_ACCENT), slider_min_units, slider_max_units);

    create_description_label(parent, "Set how long grounds stay fresh before showing purge prompt.");

    // Slider for grind freshness hours (discrete steps: 0.5, 1, 2, 3, 4, 8, 12, 24, 48)
    create_slider_row(parent, "Freshness", &grind_freshness_hours_label, &grind_freshness_hours_slider,
                     lv_color_hex(THEME_COLOR_ACCENT), 0, 8);  // 9 positions (0-8)

    // Motor response section
    create_separator(parent, "Motor Response");
    create_description_label(parent, "Minimum run time before grounds begin to flow. Pulse Tune updates this automatically.");

    create_slider_row(parent, "Motor latency", &motor_latency_label, &motor_latency_slider,
                      lv_color_hex(THEME_COLOR_ACCENT),
                      static_cast<uint32_t>(GRIND_AUTOTUNE_LATENCY_MIN_MS),
                      static_cast<uint32_t>(GRIND_AUTOTUNE_LATENCY_MAX_MS));
    create_description_label(parent, "Adjust manually only when Pulse Tune cannot complete reliably.");

    // Coast Compensation section
    create_separator(parent, "Coast Compensation");
    create_description_label(parent, "How much coast the system expects after motor stop. Higher values reduce overshoot.");

    // Slider for coast ratio (0.70 to 1.50 in 0.05 steps)
    const uint32_t coast_slider_min = static_cast<uint32_t>(GRIND_LATENCY_TO_COAST_RATIO_MIN * kCoastRatioSliderScale + 0.5f);
    const uint32_t coast_slider_max = static_cast<uint32_t>(GRIND_LATENCY_TO_COAST_RATIO_MAX * kCoastRatioSliderScale + 0.5f);
    create_slider_row(parent, "Coast Ratio", &coast_ratio_label, &coast_ratio_slider,
                     lv_color_hex(THEME_COLOR_ACCENT), coast_slider_min, coast_slider_max);

    // Register events for the toggles (done here because widgets are created lazily)
    using ET = EventBridgeLVGL::EventType;
    if (grind_mode_swipe_toggle) {
        lv_obj_add_event_cb(grind_mode_swipe_toggle, EventBridgeLVGL::dispatch_event, LV_EVENT_VALUE_CHANGED,
                           reinterpret_cast<void*>(static_cast<intptr_t>(ET::GRIND_MODE_SWIPE_TOGGLE)));
    }
    if (auto_start_toggle) {
        lv_obj_add_event_cb(auto_start_toggle, EventBridgeLVGL::dispatch_event, LV_EVENT_VALUE_CHANGED,
                           reinterpret_cast<void*>(static_cast<intptr_t>(ET::AUTO_START_TOGGLE)));
    }
    if (auto_start_threshold_slider) {
        lv_obj_add_event_cb(auto_start_threshold_slider, EventBridgeLVGL::dispatch_event, LV_EVENT_VALUE_CHANGED,
                           reinterpret_cast<void*>(static_cast<intptr_t>(ET::AUTO_START_THRESHOLD_SLIDER)));
        lv_obj_add_event_cb(auto_start_threshold_slider, EventBridgeLVGL::dispatch_event, LV_EVENT_RELEASED,
                           reinterpret_cast<void*>(static_cast<intptr_t>(ET::AUTO_START_THRESHOLD_SLIDER_RELEASED)));
    }
    if (auto_return_toggle) {
        lv_obj_add_event_cb(auto_return_toggle, EventBridgeLVGL::dispatch_event, LV_EVENT_VALUE_CHANGED,
                           reinterpret_cast<void*>(static_cast<intptr_t>(ET::AUTO_RETURN_TOGGLE)));
    }
    if (grinder_purge_amount_slider) {
        lv_obj_add_event_cb(grinder_purge_amount_slider, EventBridgeLVGL::dispatch_event, LV_EVENT_VALUE_CHANGED,
                           reinterpret_cast<void*>(static_cast<intptr_t>(ET::GRINDER_PURGE_AMOUNT_SLIDER)));
        lv_obj_add_event_cb(grinder_purge_amount_slider, EventBridgeLVGL::dispatch_event, LV_EVENT_RELEASED,
                           reinterpret_cast<void*>(static_cast<intptr_t>(ET::GRINDER_PURGE_AMOUNT_SLIDER_RELEASED)));
    }
    if (grind_freshness_hours_slider) {
        lv_obj_add_event_cb(grind_freshness_hours_slider, EventBridgeLVGL::dispatch_event, LV_EVENT_VALUE_CHANGED,
                           reinterpret_cast<void*>(static_cast<intptr_t>(ET::GRIND_FRESHNESS_HOURS_SLIDER)));
        lv_obj_add_event_cb(grind_freshness_hours_slider, EventBridgeLVGL::dispatch_event, LV_EVENT_RELEASED,
                           reinterpret_cast<void*>(static_cast<intptr_t>(ET::GRIND_FRESHNESS_HOURS_SLIDER_RELEASED)));
    }
    if (coast_ratio_slider) {
        lv_obj_add_event_cb(coast_ratio_slider, EventBridgeLVGL::dispatch_event, LV_EVENT_VALUE_CHANGED,
                           reinterpret_cast<void*>(static_cast<intptr_t>(ET::COAST_RATIO_SLIDER)));
        lv_obj_add_event_cb(coast_ratio_slider, EventBridgeLVGL::dispatch_event, LV_EVENT_RELEASED,
                           reinterpret_cast<void*>(static_cast<intptr_t>(ET::COAST_RATIO_SLIDER_RELEASED)));
    }
    if (motor_latency_slider) {
        lv_obj_add_event_cb(motor_latency_slider, EventBridgeLVGL::dispatch_event, LV_EVENT_VALUE_CHANGED,
                           reinterpret_cast<void*>(static_cast<intptr_t>(ET::MOTOR_LATENCY_SLIDER)));
        lv_obj_add_event_cb(motor_latency_slider, EventBridgeLVGL::dispatch_event, LV_EVENT_RELEASED,
                           reinterpret_cast<void*>(static_cast<intptr_t>(ET::MOTOR_LATENCY_SLIDER_RELEASED)));
    }
}

void MenuScreen::create_scale_page(lv_obj_t* parent) {
    lv_obj_set_layout(parent, LV_LAYOUT_FLEX);
    lv_obj_set_flex_flow(parent, LV_FLEX_FLOW_COLUMN);
    lv_obj_set_flex_align(parent, LV_FLEX_ALIGN_CENTER, LV_FLEX_ALIGN_CENTER, LV_FLEX_ALIGN_CENTER);
    lv_obj_set_style_pad_all(parent, 24, 0);
    lv_obj_set_style_pad_gap(parent, 28, 0);
    lv_obj_set_scrollbar_mode(parent, LV_SCROLLBAR_MODE_OFF);
    lv_obj_set_style_bg_opa(parent, LV_OPA_TRANSP, 0);

    lv_obj_t* subtitle = lv_label_create(parent);
    lv_label_set_text(subtitle, "Live weight");
    lv_obj_set_style_text_font(subtitle, &lv_font_montserrat_24, 0);
    lv_obj_set_style_text_color(subtitle, lv_color_hex(THEME_COLOR_TEXT_SECONDARY), 0);

    scale_weight_label = lv_label_create(parent);
    lv_label_set_text(scale_weight_label, "0.0g");
    lv_obj_set_style_text_font(scale_weight_label, &lv_font_montserrat_56, 0);
    lv_obj_set_style_text_color(scale_weight_label, lv_color_hex(THEME_COLOR_TEXT_PRIMARY), 0);
    lv_obj_set_style_text_align(scale_weight_label, LV_TEXT_ALIGN_CENTER, 0);

    lv_obj_t* spacer = lv_obj_create(parent);
    lv_obj_set_size(spacer, LV_PCT(100), 0);
    lv_obj_set_style_bg_opa(spacer, LV_OPA_TRANSP, 0);
    lv_obj_set_style_border_width(spacer, 0, 0);
    lv_obj_set_flex_grow(spacer, 1);

    scale_tare_button = create_button(parent, "TARE", lv_color_hex(THEME_COLOR_PRIMARY), 260, 80, &lv_font_montserrat_28);
    using ET = EventBridgeLVGL::EventType;
    if (scale_tare_button) {
        lv_obj_add_event_cb(scale_tare_button, EventBridgeLVGL::dispatch_event, LV_EVENT_CLICKED,
                           reinterpret_cast<void*>(static_cast<intptr_t>(ET::MENU_SCALE_TARE)));
    }
}

void MenuScreen::create_grind_knob_page(lv_obj_t* parent) {
    lv_obj_set_layout(parent, LV_LAYOUT_FLEX);
    lv_obj_set_flex_flow(parent, LV_FLEX_FLOW_COLUMN);
    lv_obj_set_flex_align(parent, LV_FLEX_ALIGN_START, LV_FLEX_ALIGN_CENTER, LV_FLEX_ALIGN_CENTER);
    lv_obj_set_style_pad_all(parent, 10, 0);
    lv_obj_set_style_pad_gap(parent, 8, 0);
    lv_obj_set_scroll_dir(parent, LV_DIR_VER);
    lv_obj_set_scrollbar_mode(parent, LV_SCROLLBAR_MODE_AUTO);

    // Live Tracking Section
    create_separator(parent, "Live Position");

    knob_dial_label = lv_label_create(parent);
    lv_label_set_text(knob_dial_label, "--");
    lv_obj_set_style_text_font(knob_dial_label, &lv_font_montserrat_56, 0);
    lv_obj_set_style_text_color(knob_dial_label, lv_color_hex(THEME_COLOR_TEXT_PRIMARY), 0);
    lv_obj_set_style_text_align(knob_dial_label, LV_TEXT_ALIGN_CENTER, 0);

    create_data_label(parent, "Raw ADC:", &knob_adc_label);
    if (knob_adc_label) {
        lv_label_set_text(knob_adc_label, "--");
    }

    create_data_label(parent, "Comp ADC:", &knob_comp_adc_label);
    if (knob_comp_adc_label) {
        lv_label_set_text(knob_comp_adc_label, "--");
    }

    create_data_label(parent, "Die Temp:", &knob_temp_label);
    if (knob_temp_label) {
        lv_label_set_text(knob_temp_label, "--");
    }

    // 6-Point Calibration Section
    create_separator(parent, "6-Point Calibration");
    create_description_label(parent, "Set knob to dial setting, then tap READ to record ADC value.");

    using ET = EventBridgeLVGL::EventType;

    for (int i = 0; i < HW_HALL_NUM_CAL_POINTS; i++) {
        // Container row for each calibration point
        lv_obj_t* row = lv_obj_create(parent);
        style_as_button(row, 260, LV_SIZE_CONTENT);
        lv_obj_set_style_margin_bottom(row, 6, 0);
        lv_obj_set_style_pad_all(row, 10, 0);
        lv_obj_set_layout(row, LV_LAYOUT_FLEX);
        lv_obj_set_flex_flow(row, LV_FLEX_FLOW_ROW);
        lv_obj_set_flex_align(row, LV_FLEX_ALIGN_SPACE_BETWEEN, LV_FLEX_ALIGN_CENTER, LV_FLEX_ALIGN_CENTER);

        // Left info column
        lv_obj_t* col = lv_obj_create(row);
        lv_obj_set_style_bg_opa(col, LV_OPA_TRANSP, 0);
        lv_obj_set_style_border_width(col, 0, 0);
        lv_obj_set_style_pad_all(col, 0, 0);
        lv_obj_set_layout(col, LV_LAYOUT_FLEX);
        lv_obj_set_flex_flow(col, LV_FLEX_FLOW_COLUMN);
        lv_obj_set_flex_align(col, LV_FLEX_ALIGN_START, LV_FLEX_ALIGN_START, LV_FLEX_ALIGN_START);
        lv_obj_clear_flag(col, LV_OBJ_FLAG_SCROLLABLE);

        char pt_name[24];
        snprintf(pt_name, sizeof(pt_name), i == 0 ? "Dial 0.0 (Touch)" : "Dial %.1f", static_cast<float>(i));
        lv_obj_t* title_lbl = lv_label_create(col);
        lv_label_set_text(title_lbl, pt_name);
        lv_obj_set_style_text_font(title_lbl, &lv_font_montserrat_24, 0);
        lv_obj_set_style_text_color(title_lbl, lv_color_hex(THEME_COLOR_TEXT_PRIMARY), 0);

        knob_cal_status_labels[i] = lv_label_create(col);
        lv_label_set_text(knob_cal_status_labels[i], "Not set");
        lv_obj_set_style_text_font(knob_cal_status_labels[i], &lv_font_montserrat_24, 0);
        lv_obj_set_style_text_color(knob_cal_status_labels[i], lv_color_hex(THEME_COLOR_TEXT_SECONDARY), 0);

        // Read button
        knob_cal_read_buttons[i] = create_button(row, "READ", lv_color_hex(THEME_COLOR_PRIMARY), 80, 44, &lv_font_montserrat_24);
        lv_obj_set_user_data(knob_cal_read_buttons[i], reinterpret_cast<void*>(static_cast<intptr_t>(i)));
        lv_obj_add_event_cb(knob_cal_read_buttons[i], EventBridgeLVGL::dispatch_event, LV_EVENT_CLICKED,
                            reinterpret_cast<void*>(static_cast<intptr_t>(ET::HALL_CAL_RECORD_POINT)));
    }

    knob_clear_button = create_button(parent, "Clear Calibration", lv_color_hex(THEME_COLOR_WARNING));
    lv_obj_set_style_margin_top(knob_clear_button, 10, 0);
    lv_obj_set_style_margin_bottom(knob_clear_button, 16, 0);
    if (knob_clear_button) {
        lv_obj_add_event_cb(knob_clear_button, EventBridgeLVGL::dispatch_event, LV_EVENT_CLICKED,
                            reinterpret_cast<void*>(static_cast<intptr_t>(ET::HALL_CAL_CLEAR)));
    }

    // Thermal Drift Compensation Section
    create_separator(parent, "Thermal Drift Compensation");
    create_description_label(parent, "Compensates raw Hall sensor drift caused by internal board warm-up.");

    create_toggle_row(parent, "Enable Comp", &knob_temp_comp_toggle);
    if (knob_temp_comp_toggle) {
        lv_obj_add_event_cb(knob_temp_comp_toggle, EventBridgeLVGL::dispatch_event, LV_EVENT_VALUE_CHANGED,
                            reinterpret_cast<void*>(static_cast<intptr_t>(ET::HALL_DRIFT_TOGGLE_COMP)));
    }

    create_data_label(parent, "Coeff:", &knob_drift_coeff_label);
    create_data_label(parent, "Ref Temp:", &knob_drift_ref_label);

    knob_drift_cal_button = create_button(parent, "Calibrate Drift", lv_color_hex(THEME_COLOR_PRIMARY));
    if (knob_drift_cal_button) {
        lv_obj_set_style_margin_top(knob_drift_cal_button, 6, 0);
        lv_obj_set_style_margin_bottom(knob_drift_cal_button, 10, 0);
        lv_obj_add_event_cb(knob_drift_cal_button, EventBridgeLVGL::dispatch_event, LV_EVENT_CLICKED,
                            reinterpret_cast<void*>(static_cast<intptr_t>(ET::HALL_DRIFT_CAL_START)));
    }

    // Drift calibration in-progress container (hidden by default)
    knob_drift_cal_container = lv_obj_create(parent);
    style_as_button(knob_drift_cal_container, 260, LV_SIZE_CONTENT);
    lv_obj_set_layout(knob_drift_cal_container, LV_LAYOUT_FLEX);
    lv_obj_set_flex_flow(knob_drift_cal_container, LV_FLEX_FLOW_COLUMN);
    lv_obj_set_flex_align(knob_drift_cal_container, LV_FLEX_ALIGN_START, LV_FLEX_ALIGN_CENTER, LV_FLEX_ALIGN_CENTER);
    lv_obj_set_style_pad_all(knob_drift_cal_container, 10, 0);
    lv_obj_set_style_margin_bottom(knob_drift_cal_container, 20, 0);
    lv_obj_add_flag(knob_drift_cal_container, LV_OBJ_FLAG_HIDDEN);

    knob_drift_status_label = lv_label_create(knob_drift_cal_container);
    lv_label_set_text(knob_drift_status_label, "Keep knob still!\nMeasuring drift...");
    lv_obj_set_style_text_font(knob_drift_status_label, &lv_font_montserrat_24, 0);
    lv_obj_set_style_text_align(knob_drift_status_label, LV_TEXT_ALIGN_CENTER, 0);
    lv_obj_set_style_text_color(knob_drift_status_label, lv_color_hex(THEME_COLOR_WARNING), 0);

    knob_drift_detail_label = lv_label_create(knob_drift_cal_container);
    lv_label_set_text(knob_drift_detail_label, "--");
    lv_obj_set_style_text_font(knob_drift_detail_label, &lv_font_montserrat_24, 0);
    lv_obj_set_style_text_align(knob_drift_detail_label, LV_TEXT_ALIGN_CENTER, 0);
    lv_obj_set_style_margin_top(knob_drift_detail_label, 6, 0);
    lv_obj_set_style_margin_bottom(knob_drift_detail_label, 10, 0);

    // Row with Save and Cancel buttons
    lv_obj_t* btn_row = lv_obj_create(knob_drift_cal_container);
    lv_obj_set_size(btn_row, 240, 50);
    lv_obj_set_style_bg_opa(btn_row, LV_OPA_TRANSP, 0);
    lv_obj_set_style_border_width(btn_row, 0, 0);
    lv_obj_set_style_pad_all(btn_row, 0, 0);
    lv_obj_set_layout(btn_row, LV_LAYOUT_FLEX);
    lv_obj_set_flex_flow(btn_row, LV_FLEX_FLOW_ROW);
    lv_obj_set_flex_align(btn_row, LV_FLEX_ALIGN_SPACE_BETWEEN, LV_FLEX_ALIGN_CENTER, LV_FLEX_ALIGN_CENTER);

    knob_drift_save_button = create_button(btn_row, "SAVE", lv_color_hex(THEME_COLOR_SUCCESS), 110, 44, &lv_font_montserrat_24);
    if (knob_drift_save_button) {
        lv_obj_add_event_cb(knob_drift_save_button, EventBridgeLVGL::dispatch_event, LV_EVENT_CLICKED,
                            reinterpret_cast<void*>(static_cast<intptr_t>(ET::HALL_DRIFT_CAL_FINISH)));
    }

    knob_drift_cancel_button = create_button(btn_row, "CANCEL", lv_color_hex(THEME_COLOR_WARNING), 110, 44, &lv_font_montserrat_24);
    if (knob_drift_cancel_button) {
        lv_obj_add_event_cb(knob_drift_cancel_button, EventBridgeLVGL::dispatch_event, LV_EVENT_CLICKED,
                            reinterpret_cast<void*>(static_cast<intptr_t>(ET::HALL_DRIFT_CAL_CANCEL)));
    }
}

void MenuScreen::create_data_page(lv_obj_t* parent) {
    lv_obj_set_layout(parent, LV_LAYOUT_FLEX);
    lv_obj_set_flex_flow(parent, LV_FLEX_FLOW_COLUMN);
    lv_obj_set_flex_align(parent, LV_FLEX_ALIGN_START, LV_FLEX_ALIGN_CENTER, LV_FLEX_ALIGN_CENTER);
    
    // Enable vertical scrolling on the reset page
    lv_obj_set_scroll_dir(parent, LV_DIR_VER);
    lv_obj_set_scrollbar_mode(parent, LV_SCROLLBAR_MODE_AUTO);

    create_description_label(parent, "Saved grind logs stored on the grinder for export/analysis.");

    create_toggle_row(parent, "Logging", &logging_toggle);

    // Log data section
    create_separator(parent, "Log Data");
    create_data_label(parent, "Sessions:", &sessions_label);
    create_data_label(parent, "Events:", &events_label);
    create_data_label(parent, "Metrics:", &measurements_label);

    // Reset separator
    create_separator(parent, "Reset");

    purge_button = create_button(parent, "Purge Logs", lv_color_hex(THEME_COLOR_WARNING));
    lv_obj_set_style_margin_bottom(purge_button, 10, 0);
    reset_button = create_button(parent, "Factory Reset", lv_color_hex(THEME_COLOR_ERROR));

    // Register events for the toggle and buttons (done here because widgets are created lazily)
    using ET = EventBridgeLVGL::EventType;
    if (logging_toggle) {
        lv_obj_add_event_cb(logging_toggle, EventBridgeLVGL::dispatch_event, LV_EVENT_VALUE_CHANGED,
                           reinterpret_cast<void*>(static_cast<intptr_t>(ET::LOGGING_TOGGLE)));
    }
    if (purge_button) {
        lv_obj_add_event_cb(purge_button, EventBridgeLVGL::dispatch_event, LV_EVENT_CLICKED,
                           reinterpret_cast<void*>(static_cast<intptr_t>(ET::MENU_PURGE)));
    }
    if (reset_button) {
        lv_obj_add_event_cb(reset_button, EventBridgeLVGL::dispatch_event, LV_EVENT_CLICKED,
                           reinterpret_cast<void*>(static_cast<intptr_t>(ET::MENU_RESET)));
    }
}

void MenuScreen::create_stats_page(lv_obj_t* parent) {
    lv_obj_set_layout(parent, LV_LAYOUT_FLEX);
    lv_obj_set_flex_flow(parent, LV_FLEX_FLOW_COLUMN);
    lv_obj_set_flex_align(parent, LV_FLEX_ALIGN_START, LV_FLEX_ALIGN_CENTER, LV_FLEX_ALIGN_CENTER);

    lv_obj_set_scroll_dir(parent, LV_DIR_VER);
    lv_obj_set_scrollbar_mode(parent, LV_SCROLLBAR_MODE_AUTO);

    create_description_label(parent, "Lifetime totals for the grinder.");

    create_separator(parent, "Lifetime Statistics");
    create_data_label(parent, "Total Grinds:", &stat_total_grinds_label, true);
    create_data_label(parent, "Shots (S/D/C):", &stat_shots_label, true);
    create_data_label(parent, "Motor Runtime:", &stat_motor_runtime_label, true);
    create_data_label(parent, "Device Uptime:", &stat_device_uptime_label, true);
    create_data_label(parent, "Total Weight:", &stat_total_weight_label, true);
    create_data_label(parent, "Mode (W/T):", &stat_mode_grinds_label, true);
    create_data_label(parent, "Avg Accuracy:", &stat_avg_accuracy_label, true);
    create_data_label(parent, "Total Pulses:", &stat_total_pulses_label, true);

    refresh_stats_button = create_button(parent, "Refresh Stats");
    lv_obj_set_style_margin_top(refresh_stats_button, 10, 0);

    // Register event for the button (done here because widgets are created lazily)
    using ET = EventBridgeLVGL::EventType;
    if (refresh_stats_button) {
        lv_obj_add_event_cb(refresh_stats_button, EventBridgeLVGL::dispatch_event, LV_EVENT_CLICKED,
                           reinterpret_cast<void*>(static_cast<intptr_t>(ET::MENU_REFRESH_STATS)));
    }
}

void MenuScreen::create_diagnostics_page(lv_obj_t* parent) {
    lv_obj_set_layout(parent, LV_LAYOUT_FLEX);
    lv_obj_set_flex_flow(parent, LV_FLEX_FLOW_COLUMN);
    lv_obj_set_flex_align(parent, LV_FLEX_ALIGN_START, LV_FLEX_ALIGN_CENTER, LV_FLEX_ALIGN_CENTER);
    lv_obj_set_style_pad_all(parent, 0, 0);

    // Enable vertical scrolling
    lv_obj_set_scroll_dir(parent, LV_DIR_VER);
    lv_obj_set_scrollbar_mode(parent, LV_SCROLLBAR_MODE_AUTO);

    // Load Cell Status separator
    create_separator(parent, "Load Cell Status");

    // Status indicator
    create_data_label(parent, "Status:", &diag_status_label);

    // Calibration factor - stacked for long decimal values
    create_data_label(parent, "Cal. factor:", &diag_calibration_factor_label);

    // Info label (only shown when not calibrated)
    diag_info_label = lv_label_create(parent);
    lv_label_set_text(diag_info_label, "");
    lv_obj_set_style_text_font(diag_info_label, &lv_font_montserrat_24, 0);
    lv_obj_set_style_text_color(diag_info_label, lv_color_hex(THEME_COLOR_WARNING), 0);
    lv_obj_set_style_margin_top(diag_info_label, 10, 0);
    lv_obj_set_style_margin_bottom(diag_info_label, 10, 0);
    lv_label_set_long_mode(diag_info_label, LV_LABEL_LONG_WRAP);
    lv_obj_set_width(diag_info_label, 260);
    lv_obj_add_flag(diag_info_label, LV_OBJ_FLAG_HIDDEN); // Hidden by default

    diag_reset_button = create_button(parent, "Reset Diagnostics", lv_color_hex(THEME_COLOR_WARNING));
    lv_obj_set_style_margin_bottom(diag_reset_button, 10, 0);

    // Noise Floor separator
    create_separator(parent, "Noise Floor");

    // Std dev readings (moved from System Info) - stacked for precision values
    create_data_label(parent, "Std Dev (g):", &diag_std_dev_g_label);
    create_data_label(parent, "Std Dev (ADC):", &diag_std_dev_adc_label);
    create_data_label(parent, "Noise level:", &diag_noise_level_label);

    // Static info label about calibration dependency
    lv_obj_t* cal_info = lv_label_create(parent);
    lv_label_set_text(cal_info, "Noise level readings depend on proper calibration.");
    lv_obj_set_style_text_font(cal_info, &lv_font_montserrat_24, 0);
    lv_obj_set_style_text_color(cal_info, lv_color_hex(THEME_COLOR_TEXT_SECONDARY), 0);
    lv_obj_set_style_margin_top(cal_info, 10, 0);
    lv_label_set_long_mode(cal_info, LV_LABEL_LONG_WRAP);
    lv_obj_set_width(cal_info, 260);

    // Motor Response separator
    create_separator(parent, "Motor Response");

    // Motor latency
    create_data_label(parent, "Motor Latency:", &diag_motor_latency_label, true);

    // Register event for the button (done here because widgets are created lazily)
    using ET = EventBridgeLVGL::EventType;
    if (diag_reset_button) {
        lv_obj_add_event_cb(diag_reset_button, EventBridgeLVGL::dispatch_event, LV_EVENT_CLICKED,
                           reinterpret_cast<void*>(static_cast<intptr_t>(ET::MENU_DIAGNOSTIC_RESET)));
    }
}

void MenuScreen::show() {
    LOG_BLE("[%lums MENU] Showing menu screen\n", millis());

    lv_obj_clear_flag(screen, LV_OBJ_FLAG_HIDDEN);
    visible = true;
    update_ble_status();
    update_brightness_sliders();
    update_bluetooth_startup_toggle();
    update_logging_toggle();
    update_grind_mode_toggles();
    update_screensaver_toggles();

    LOG_BLE("[%lums MENU] Menu screen shown successfully\n", millis());
}

void MenuScreen::hide() {
    if (!visible) {
        return; // Already hidden, nothing to do
    }

    LOG_BLE("[%lums MENU] Hiding menu screen\n", millis());

    // Keep the menu in memory for instant access next time
    // Just hide the screen instead of deleting the menu
    lv_obj_add_flag(screen, LV_OBJ_FLAG_HIDDEN);
    visible = false;
    LOG_BLE("[%lums MENU] Menu screen hidden successfully\n", millis());
}

void MenuScreen::update_info(const WeightSensor* weight_sensor, unsigned long uptime_ms, size_t free_heap) {
    if (!visible) return;

    set_label_text_float(instant_label, weight_sensor->get_instant_weight(), "g");
    set_label_text_int(samples_label, weight_sensor->get_sample_count());
    set_label_text_int(raw_label, weight_sensor->get_raw_adc_instant());

    // Update uptime - use compact format to avoid horizontal scrolling
    unsigned long seconds = uptime_ms / 1000;
    unsigned long hours = seconds / 3600;
    unsigned long minutes = (seconds % 3600) / 60;
    seconds = seconds % 60;

    char uptime_text[48];
    snprintf(uptime_text, sizeof(uptime_text), "%02lu:%02lu:%02lu", hours, minutes, seconds);
    lv_label_set_text(uptime_label, uptime_text);

    set_label_text_int(memory_label, free_heap / 1024, "kB");
}

void MenuScreen::update_diagnostics(WeightSensor* weight_sensor) {
    if (!visible || !diagnostics_controller) return;

    // Update standard deviations only every 1 second to reduce noise
    static unsigned long last_std_dev_update = 0;
    unsigned long now = millis();
    if (now - last_std_dev_update >= 1000) {  // Update every 1 second
        last_std_dev_update = now;

        // Get standard deviations using same window as grind control precision settling
        float std_dev_g = weight_sensor->get_standard_deviation_g(GRIND_SCALE_PRECISION_SETTLING_TIME_MS);  // 500ms window
        int32_t std_dev_adc = weight_sensor->get_standard_deviation_adc(GRIND_SCALE_PRECISION_SETTLING_TIME_MS);  // 500ms window

        char std_dev_g_text[32];
        snprintf(std_dev_g_text, sizeof(std_dev_g_text), "%.4f", std_dev_g);
        lv_label_set_text(diag_std_dev_g_label, std_dev_g_text);

        set_label_text_int(diag_std_dev_adc_label, std_dev_adc);

        // Check noise level using WeightSensor diagnostic method
        bool noise_acceptable = weight_sensor->noise_level_diagnostic();

        // Update noise level indicator
        if (noise_acceptable) {
            lv_label_set_text(diag_noise_level_label, "OK");
            lv_obj_set_style_text_color(diag_noise_level_label, lv_color_hex(THEME_COLOR_TEXT_SECONDARY), 0);
        } else {
            lv_label_set_text(diag_noise_level_label, "Too High");
            lv_obj_set_style_text_color(diag_noise_level_label, lv_color_hex(THEME_COLOR_ERROR), 0);
        }
    }

    // Update calibration factor
    float cal_factor = weight_sensor->get_calibration_factor();
    char cal_factor_text[32];
    snprintf(cal_factor_text, sizeof(cal_factor_text), "%.2f", cal_factor);
    lv_label_set_text(diag_calibration_factor_label, cal_factor_text);

    // Update motor latency
    if (grind_controller) {
        float motor_latency = grind_controller->get_motor_response_latency();
        char latency_text[32];
        snprintf(latency_text, sizeof(latency_text), "%.0f ms", motor_latency);
        lv_label_set_text(diag_motor_latency_label, latency_text);
    } else {
        lv_label_set_text(diag_motor_latency_label, "-- ms");
    }

    // Get highest priority diagnostic
    DiagnosticCode diagnostic = diagnostics_controller->get_highest_priority_warning();

    // Update status label
    if (diagnostic == DiagnosticCode::NONE) {
        lv_label_set_text(diag_status_label, "OK");
        lv_obj_set_style_text_color(diag_status_label, lv_color_hex(THEME_COLOR_SUCCESS), 0);
        lv_obj_add_flag(diag_info_label, LV_OBJ_FLAG_HIDDEN);
    } else {
        lv_label_set_text(diag_status_label, LV_SYMBOL_WARNING " Warning");
        lv_obj_set_style_text_color(diag_status_label, lv_color_hex(THEME_COLOR_WARNING), 0);

        // Show appropriate warning message
        if (diagnostic == DiagnosticCode::LOAD_CELL_NOT_CALIBRATED) {
            lv_label_set_text(diag_info_label, "Loadcell not calibrated");
            lv_obj_clear_flag(diag_info_label, LV_OBJ_FLAG_HIDDEN);
        } else {
            // For future noise/mechanical warnings, show in info label
            const char* message = diagnostics_controller->get_diagnostic_message(diagnostic);
            lv_label_set_text(diag_info_label, message);
            lv_obj_clear_flag(diag_info_label, LV_OBJ_FLAG_HIDDEN);
        }
    }
}

void MenuScreen::update_ble_status() {
    if (!visible || !bluetooth_manager) return;
    
    // Update toggle state
    if (bluetooth_manager->is_enabled()) {
        lv_obj_add_state(ble_toggle, LV_STATE_CHECKED);
    } else {
        lv_obj_clear_state(ble_toggle, LV_STATE_CHECKED);
    }
    
    // Update status text
    if (bluetooth_manager->is_enabled()) {
        if (bluetooth_manager->is_connected()) {
            lv_label_set_text(ble_status_label, "Connected");
        } else {
            lv_label_set_text(ble_status_label, "Advertising");
        }
        lv_obj_clear_flag(ble_status_label, LV_OBJ_FLAG_HIDDEN);
        
        // Show remaining time
        unsigned long remaining_ms = bluetooth_manager->get_bluetooth_timeout_remaining_ms();
        unsigned long remaining_min = remaining_ms / (60 * 1000);
        char timer_text[64];
        snprintf(timer_text, sizeof(timer_text), "Auto-disable in: %lu min", remaining_min);
        lv_label_set_text(ble_timer_label, timer_text);
        lv_obj_clear_flag(ble_timer_label, LV_OBJ_FLAG_HIDDEN);
    } else {
        // When nothing to display hide the status labels
        lv_obj_add_flag(ble_status_label, LV_OBJ_FLAG_HIDDEN);
        lv_obj_add_flag(ble_timer_label, LV_OBJ_FLAG_HIDDEN);
    }
}

void MenuScreen::refresh_statistics(bool show_overlay) {
    if (!visible) return;

    // Define the statistics loading operation
    auto load_statistics_operation = [this]() {
        // Log data
        set_label_text_int(sessions_label, grind_logger.get_total_flash_sessions());
        set_label_text_int(events_label, grind_logger.count_total_events_in_flash());
        set_label_text_int(measurements_label, grind_logger.count_total_measurements_in_flash());

        // Lifetime statistics
        set_label_text_int(stat_total_grinds_label, statistics_manager.get_total_grinds());

        // Shot type breakdown (Single/Double/Custom)
        char shot_text[32];
        snprintf(shot_text, sizeof(shot_text), "%lu / %lu / %lu",
                 statistics_manager.get_single_shots(),
                 statistics_manager.get_double_shots(),
                 statistics_manager.get_custom_shots());
        lv_label_set_text(stat_shots_label, shot_text);

        // Motor runtime (convert seconds to hours:minutes)
        uint64_t runtime_ms = statistics_manager.get_motor_runtime_ms();
        uint32_t runtime_sec = static_cast<uint32_t>(runtime_ms / 1000ULL);
        uint32_t hours = runtime_sec / 3600;
        uint32_t minutes = (runtime_sec % 3600) / 60;
        uint32_t seconds = runtime_sec % 60;
        char runtime_text[32];
        if (runtime_sec >= 3600) {
            snprintf(runtime_text, sizeof(runtime_text), "%luh %lum", hours, minutes);
        } else if (runtime_sec >= 60) {
            snprintf(runtime_text, sizeof(runtime_text), "%lum %lus", minutes, seconds);
        } else if (runtime_ms >= 1000) {
            float seconds_float = static_cast<float>(runtime_ms) / 1000.0f;
            snprintf(runtime_text, sizeof(runtime_text), "%.1fs", seconds_float);
        } else {
            snprintf(runtime_text, sizeof(runtime_text), "%llums", static_cast<unsigned long long>(runtime_ms));
        }
        lv_label_set_text(stat_motor_runtime_label, runtime_text);

        // Device uptime
        char uptime_text[32];
        uint32_t uptime_hours = statistics_manager.get_device_uptime_hrs();
        uint32_t uptime_minutes = statistics_manager.get_device_uptime_min_remainder();
        snprintf(uptime_text, sizeof(uptime_text), "%luh %lum", uptime_hours, uptime_minutes);
        lv_label_set_text(stat_device_uptime_label, uptime_text);

        // Total weight
        char weight_text[32];
        snprintf(weight_text, sizeof(weight_text), "%.2f kg", statistics_manager.get_total_weight_kg());
        lv_label_set_text(stat_total_weight_label, weight_text);

        // Mode grinds (Weight/Time)
        char mode_text[32];
        snprintf(mode_text, sizeof(mode_text), "%lu / %lu",
                 statistics_manager.get_weight_mode_grinds(),
                 statistics_manager.get_time_mode_grinds());
        lv_label_set_text(stat_mode_grinds_label, mode_text);

        // Average accuracy
        char accuracy_text[32];
        snprintf(accuracy_text, sizeof(accuracy_text), "%.2fg", statistics_manager.get_avg_accuracy_g());
        lv_label_set_text(stat_avg_accuracy_label, accuracy_text);

        // Total pulses (also show average)
        char pulses_text[32];
        snprintf(pulses_text, sizeof(pulses_text), "%lu (avg: %.1f)",
                 statistics_manager.get_total_pulses(),
                 statistics_manager.get_avg_pulses());
        lv_label_set_text(stat_total_pulses_label, pulses_text);
    };

    // Used for when we reload the statistics after a data purge
    if (!show_overlay){
        load_statistics_operation();
        return;
    }

    // Show blocking overlay while loading statistics
    auto& overlay = BlockingOperationOverlay::getInstance();
    overlay.show_and_execute(BlockingOperation::LOADING_STATISTICS, load_statistics_operation);
}

void MenuScreen::update_brightness_sliders() {
    if (!hardware_manager || !brightness_normal_slider || !brightness_screensaver_slider) return;
    
    // Read from the dedicated "brightness" namespace using a local Preferences
    // instance so we don't interfere with the global shared handle.
    Preferences prefs;
    prefs.begin("brightness", false); // writable so namespace is created on first use
    
    // Load brightness values from preferences (default to compile-time values)
    float normal_brightness = prefs.getFloat("normal", USER_SCREEN_BRIGHTNESS_NORMAL);
    float screensaver_brightness = prefs.getFloat("screensaver", USER_SCREEN_BRIGHTNESS_DIMMED);
    prefs.end();
    
    // Convert from 0.0-1.0 to 15-100 range
    int normal_percent = (int)(normal_brightness * 100);
    int screensaver_percent = (int)(screensaver_brightness * 100);
    
    // Ensure minimum 15%
    if (normal_percent < HW_DISPLAY_MINIMAL_BRIGHTNESS_PERCENT) normal_percent = HW_DISPLAY_MINIMAL_BRIGHTNESS_PERCENT;
    if (screensaver_percent < HW_DISPLAY_MINIMAL_BRIGHTNESS_PERCENT) screensaver_percent = HW_DISPLAY_MINIMAL_BRIGHTNESS_PERCENT;
    
    // Update sliders
    lv_slider_set_value(brightness_normal_slider, normal_percent, LV_ANIM_OFF);
    lv_slider_set_value(brightness_screensaver_slider, screensaver_percent, LV_ANIM_OFF);
    
    update_brightness_labels(normal_percent, screensaver_percent);
}

void MenuScreen::update_brightness_labels(int normal_percent, int screensaver_percent) {
    if (brightness_normal_label && normal_percent >= 0) {
        char normal_text[32];
        snprintf(normal_text, sizeof(normal_text), "Brightness: %d%%", normal_percent);
        lv_label_set_text(brightness_normal_label, normal_text);
    }

    if (brightness_screensaver_label && screensaver_percent >= 0) {
        char screensaver_text[32];
        snprintf(screensaver_text, sizeof(screensaver_text), "Dimmed: %d%%", screensaver_percent);
        lv_label_set_text(brightness_screensaver_label, screensaver_text);
    }
}

void MenuScreen::update_grinder_purge_amount_label(float amount_g) {
    if (grinder_purge_amount_label) {
        char buffer[16];
        float clamped_amount = amount_g;
        if (clamped_amount < GRIND_PURGE_AMOUNT_MIN_G) clamped_amount = GRIND_PURGE_AMOUNT_MIN_G;
        if (clamped_amount > GRIND_PURGE_AMOUNT_MAX_G) clamped_amount = GRIND_PURGE_AMOUNT_MAX_G;
        snprintf(buffer, sizeof(buffer), "Amount: %.1fg", clamped_amount);
        lv_label_set_text(grinder_purge_amount_label, buffer);
    }
}

void MenuScreen::update_grind_freshness_hours_label(float hours) {
    if (grind_freshness_hours_label) {
        char buffer[24];
        if (hours < 1.0f) {
            snprintf(buffer, sizeof(buffer), "Freshness: %.1fh", hours);
        } else {
            snprintf(buffer, sizeof(buffer), "Freshness: %.0fh", hours);
        }
        lv_label_set_text(grind_freshness_hours_label, buffer);
    }
}

void MenuScreen::update_coast_ratio_label(float ratio) {
    if (coast_ratio_label) {
        char buffer[24];
        int percent = static_cast<int>(ratio * 100.0f + 0.5f);
        snprintf(buffer, sizeof(buffer), "Coast Ratio: %d%%", percent);
        lv_label_set_text(coast_ratio_label, buffer);
    }
}

void MenuScreen::update_motor_latency_label(float latency_ms) {
    if (!motor_latency_label) return;
    const float clamped = std::clamp(latency_ms,
                                     GRIND_AUTOTUNE_LATENCY_MIN_MS,
                                     GRIND_AUTOTUNE_LATENCY_MAX_MS);
    char buffer[28];
    snprintf(buffer, sizeof(buffer), "Motor latency: %.0fms", clamped);
    lv_label_set_text(motor_latency_label, buffer);
}

void MenuScreen::update_auto_start_threshold_label(float threshold_g) {
    if (!auto_start_threshold_label) return;
    const float clamped = std::clamp(threshold_g,
                                     USER_AUTO_GRIND_TRIGGER_MIN_G,
                                     USER_AUTO_GRIND_TRIGGER_MAX_G);
    char buffer[28];
    snprintf(buffer, sizeof(buffer), "Cup threshold: %.0fg", clamped);
    lv_label_set_text(auto_start_threshold_label, buffer);
}

void MenuScreen::update_screensaver_toggles() {
    bool image_exists = LittleFS.exists(BLE_IMAGE_FILENAME);

    Preferences prefs;
    prefs.begin("screensaver", true);
    bool startup_on = prefs.getBool("startup", false);
    bool sleep_on = prefs.getBool("sleep", false);
    prefs.end();
    const bool display_off_enabled = ScreensaverSettings::load_timing().display_off_enabled;

    if (screensaver_startup_toggle) {
        if (startup_on && image_exists) {
            lv_obj_add_state(screensaver_startup_toggle, LV_STATE_CHECKED);
        } else {
            lv_obj_clear_state(screensaver_startup_toggle, LV_STATE_CHECKED);
        }
        // Disable toggles if no image is uploaded
        if (image_exists) {
            lv_obj_clear_state(screensaver_startup_toggle, LV_STATE_DISABLED);
        } else {
            lv_obj_add_state(screensaver_startup_toggle, LV_STATE_DISABLED);
        }
    }

    if (screensaver_sleep_toggle) {
        if (sleep_on && image_exists) {
            lv_obj_add_state(screensaver_sleep_toggle, LV_STATE_CHECKED);
        } else {
            lv_obj_clear_state(screensaver_sleep_toggle, LV_STATE_CHECKED);
        }
        if (image_exists) {
            lv_obj_clear_state(screensaver_sleep_toggle, LV_STATE_DISABLED);
        } else {
            lv_obj_add_state(screensaver_sleep_toggle, LV_STATE_DISABLED);
        }
    }

    if (display_off_toggle) {
        if (display_off_enabled) {
            lv_obj_add_state(display_off_toggle, LV_STATE_CHECKED);
        } else {
            lv_obj_clear_state(display_off_toggle, LV_STATE_CHECKED);
        }
    }
}

lv_obj_t* MenuScreen::create_separator(lv_obj_t* parent, const char* text) {
    // Create separator container
    lv_obj_t* separator_container = lv_obj_create(parent);
    lv_obj_set_size(separator_container, LV_PCT(100), LV_SIZE_CONTENT);
    lv_obj_set_style_bg_opa(separator_container, LV_OPA_TRANSP, 0);
    lv_obj_set_style_border_width(separator_container, 0, 0);
    lv_obj_set_layout(separator_container, LV_LAYOUT_FLEX);
    lv_obj_set_flex_flow(separator_container, LV_FLEX_FLOW_ROW);
    lv_obj_set_flex_align(separator_container, LV_FLEX_ALIGN_CENTER, LV_FLEX_ALIGN_CENTER, LV_FLEX_ALIGN_CENTER);
    lv_obj_clear_flag(separator_container, LV_OBJ_FLAG_SCROLLABLE);

    // Create left line
    lv_obj_t* left_line = lv_obj_create(separator_container);
    lv_obj_set_size(left_line, LV_SIZE_CONTENT, 2);
    lv_obj_set_flex_grow(left_line, 1);
    lv_obj_set_style_bg_color(left_line, lv_color_hex(THEME_COLOR_TEXT_SECONDARY), 0);
    lv_obj_set_style_border_width(left_line, 0, 0);

    if (!text) {
        // If no text, make the line take full width
        return separator_container;
    }

    // Create text label
    lv_obj_t* separator_label = lv_label_create(separator_container);
    lv_label_set_text(separator_label, text);
    lv_obj_set_style_text_font(separator_label, &lv_font_montserrat_24, 0);
    lv_obj_set_style_text_color(separator_label, lv_color_hex(THEME_COLOR_TEXT_SECONDARY), 0);
    lv_obj_set_style_pad_left(separator_label, 10, 0);
    lv_obj_set_style_pad_right(separator_label, 10, 0);

    // Create right line
    lv_obj_t* right_line = lv_obj_create(separator_container);
    lv_obj_set_size(right_line, LV_SIZE_CONTENT, 2);
    lv_obj_set_flex_grow(right_line, 1);
    lv_obj_set_style_bg_color(right_line, lv_color_hex(THEME_COLOR_TEXT_SECONDARY), 0);
    lv_obj_set_style_border_width(right_line, 0, 0);

    return separator_container;
}

void MenuScreen::update_bluetooth_startup_toggle() {
    if (!ble_startup_toggle) return;

    // Read from the "bluetooth" namespace using a local Preferences instance
    Preferences prefs;
    prefs.begin("bluetooth", true); // read-only

    // Load startup value from preferences (default to false)
    bool startup_enabled = prefs.getBool("startup", true);
    prefs.end();

    // Update toggle state
    if (startup_enabled) {
        lv_obj_add_state(ble_startup_toggle, LV_STATE_CHECKED);
    } else {
        lv_obj_clear_state(ble_startup_toggle, LV_STATE_CHECKED);
    }
}

void MenuScreen::update_logging_toggle() {
    if (!logging_toggle) return;

    // Read from the "logging" namespace using a local Preferences instance
    Preferences prefs;
    prefs.begin("logging", true); // read-only

    // Load logging enabled value from preferences (default to false)
    bool logging_enabled = prefs.getBool("enabled", true);
    prefs.end();

    // Update toggle state
    if (logging_enabled) {
        lv_obj_add_state(logging_toggle, LV_STATE_CHECKED);
    } else {
        lv_obj_clear_state(logging_toggle, LV_STATE_CHECKED);
    }
}

lv_obj_t* MenuScreen::create_menu_item(lv_obj_t* parent, const char* text) {
    lv_obj_t* cont = lv_menu_cont_create(parent);
    style_as_button(cont);
    lv_obj_set_style_margin_bottom(cont, 10, 0);

    // Set layout
    lv_obj_set_layout(cont, LV_LAYOUT_FLEX);
    lv_obj_set_flex_flow(cont, LV_FLEX_FLOW_ROW);
    lv_obj_set_flex_align(cont, LV_FLEX_ALIGN_SPACE_BETWEEN, LV_FLEX_ALIGN_CENTER, LV_FLEX_ALIGN_CENTER);

    lv_obj_t* label = lv_label_create(cont);
    lv_label_set_text(label, text);

    lv_obj_t* chevron = lv_label_create(cont);
    lv_label_set_text(chevron, LV_SYMBOL_RIGHT);
    lv_obj_set_style_text_color(chevron, lv_color_hex(THEME_COLOR_SECONDARY), 0);

    return cont;
}

lv_obj_t* MenuScreen::create_toggle_row(lv_obj_t* parent, const char* text, lv_obj_t** out_toggle) {
    lv_obj_t* row_container = lv_obj_create(parent);
    style_as_button(row_container);
    lv_obj_set_style_margin_bottom(row_container, 10, 0);

    // Set layout
    lv_obj_set_layout(row_container, LV_LAYOUT_FLEX);
    lv_obj_set_flex_flow(row_container, LV_FLEX_FLOW_ROW);
    lv_obj_set_flex_align(row_container, LV_FLEX_ALIGN_SPACE_BETWEEN, LV_FLEX_ALIGN_CENTER, LV_FLEX_ALIGN_CENTER);

    lv_obj_t* label = lv_label_create(row_container);
    lv_label_set_text(label, text);

    *out_toggle = lv_switch_create(row_container);
    lv_obj_set_size(*out_toggle, 80, 40);
    lv_obj_set_ext_click_area(*out_toggle, 20);
    
    return row_container;
}


lv_obj_t* MenuScreen::create_slider_row(lv_obj_t* parent, const char* text, lv_obj_t** label, lv_obj_t** slider, lv_color_t slider_color, uint32_t min, uint32_t max) {
    lv_obj_t* row_container = lv_obj_create(parent);
    style_as_button(row_container, 260, LV_SIZE_CONTENT);
    lv_obj_set_style_margin_bottom(row_container, 10, 0);
    // Set layout

    lv_obj_set_layout(row_container, LV_LAYOUT_FLEX);
    lv_obj_set_flex_flow(row_container, LV_FLEX_FLOW_COLUMN);
    lv_obj_set_flex_align(row_container, LV_FLEX_ALIGN_START, LV_FLEX_ALIGN_CENTER, LV_FLEX_ALIGN_CENTER);
    lv_obj_set_style_pad_gap(row_container, 14, 0);
    lv_obj_set_style_pad_all(row_container, 20, 0);

    *label = lv_label_create(row_container);
    lv_label_set_text(*label, text);

    *slider = lv_slider_create(row_container);
    lv_obj_set_size(*slider, 220, 40);
    lv_obj_set_ext_click_area(*slider, 20);
    lv_slider_set_range(*slider, min, max);
    lv_obj_set_style_bg_color(*slider, lv_color_hex(THEME_COLOR_BACKGROUND), LV_PART_MAIN);
    lv_obj_set_style_bg_color(*slider, slider_color, LV_PART_INDICATOR);
    lv_obj_set_style_bg_opa(*slider, LV_OPA_TRANSP, LV_PART_KNOB);
    return row_container;
}

lv_obj_t* MenuScreen::create_static_data_label(lv_obj_t* parent, const char* name, const char* value) {
    lv_obj_t* label;
    lv_obj_t* data_label = create_data_label(parent, name, &label);
    lv_label_set_text(label, value);
    return data_label;
}

lv_obj_t* MenuScreen::create_data_label(lv_obj_t* parent, const char* name, lv_obj_t** variable, bool stacked) {
    return ::create_data_label(parent, name, variable, stacked);
}

lv_obj_t* MenuScreen::create_description_label(lv_obj_t* parent, const char* text) {
    // Create container with padding (similar to create_data_label)
    lv_obj_t* container = lv_obj_create(parent);
    lv_obj_set_style_bg_opa(container, LV_OPA_TRANSP, 0);
    lv_obj_set_style_border_width(container, 0, 0);
    lv_obj_set_style_pad_all(container, 0, 0);
    lv_obj_set_style_pad_left(container, 10, 0);
    lv_obj_set_style_pad_right(container, 14, 0);
    lv_obj_set_style_margin_top(container, 12, 0);
    lv_obj_set_style_margin_bottom(container, 12, 0);
    lv_obj_set_size(container, 280, LV_SIZE_CONTENT);
    lv_obj_clear_flag(container, LV_OBJ_FLAG_SCROLLABLE);

    // Create label inside container
    lv_obj_t* label = lv_label_create(container);
    lv_label_set_text(label, text);
    lv_obj_set_style_text_font(label, &lv_font_montserrat_24, 0);
    lv_obj_set_style_text_color(label, lv_color_hex(THEME_COLOR_TEXT_SECONDARY), 0);
    lv_label_set_long_mode(label, LV_LABEL_LONG_WRAP);
    lv_obj_set_width(label, LV_PCT(100));

    return label;
}

void MenuScreen::reset_scale_display() {
    if (scale_weight_label) {
        lv_label_set_text(scale_weight_label, "0.0g");
    }
}

void MenuScreen::update_scale_weight(float weight) {
    if (!scale_weight_label) {
        return;
    }
    char buffer[24];
    snprintf(buffer, sizeof(buffer), SYS_WEIGHT_DISPLAY_FORMAT, weight);
    lv_label_set_text(scale_weight_label, buffer);
}

void MenuScreen::reset_grind_knob_display() {
    if (knob_dial_label) {
        lv_label_set_text(knob_dial_label, "--");
    }
    if (knob_adc_label) {
        lv_label_set_text(knob_adc_label, "--");
    }
    if (knob_comp_adc_label) {
        lv_label_set_text(knob_comp_adc_label, "--");
    }
    if (knob_temp_label) {
        lv_label_set_text(knob_temp_label, "--");
    }
}

void MenuScreen::update_grind_knob_display(float dial, int32_t raw_adc, int32_t comp_adc, float temp_c) {
    if (knob_dial_label) {
        if (std::isnan(dial)) {
            lv_label_set_text(knob_dial_label, "--");
        } else {
            char buffer[16];
            snprintf(buffer, sizeof(buffer), "%.1f", dial);
            lv_label_set_text(knob_dial_label, buffer);
        }
    }
    if (knob_adc_label) {
        char buffer[16];
        snprintf(buffer, sizeof(buffer), "%ld", static_cast<long>(raw_adc));
        lv_label_set_text(knob_adc_label, buffer);
    }
    if (knob_comp_adc_label) {
        char buffer[16];
        if (comp_adc >= 0) {
            snprintf(buffer, sizeof(buffer), "%ld", static_cast<long>(comp_adc));
        } else {
            snprintf(buffer, sizeof(buffer), "--");
        }
        lv_label_set_text(knob_comp_adc_label, buffer);
    }
    if (knob_temp_label) {
        char buffer[16];
        if (!std::isnan(temp_c)) {
            snprintf(buffer, sizeof(buffer), "%.1f C", temp_c);
        } else {
            snprintf(buffer, sizeof(buffer), "--");
        }
        lv_label_set_text(knob_temp_label, buffer);
    }
}

void MenuScreen::update_drift_compensation_display(const HallSensor* hall) {
    if (!hall) return;
    if (knob_temp_comp_toggle) {
        if (hall->is_temp_comp_enabled()) {
            lv_obj_add_state(knob_temp_comp_toggle, LV_STATE_CHECKED);
        } else {
            lv_obj_clear_state(knob_temp_comp_toggle, LV_STATE_CHECKED);
        }
    }
    if (knob_drift_coeff_label) {
        char buf[32];
        snprintf(buf, sizeof(buf), "%.2f cnt/C", hall->get_temp_coeff());
        lv_label_set_text(knob_drift_coeff_label, buf);
    }
    if (knob_drift_ref_label) {
        char buf[32];
        snprintf(buf, sizeof(buf), "%.1f C", hall->get_temp_ref());
        lv_label_set_text(knob_drift_ref_label, buf);
    }
}

void MenuScreen::show_drift_cal_panel(bool show) {
    if (!knob_drift_cal_container) return;
    if (show) {
        lv_obj_clear_flag(knob_drift_cal_container, LV_OBJ_FLAG_HIDDEN);
        if (knob_drift_cal_button) {
            lv_obj_add_flag(knob_drift_cal_button, LV_OBJ_FLAG_HIDDEN);
        }
        if (knob_drift_status_label) {
            lv_label_set_text(knob_drift_status_label, "Keep knob still!\nMeasuring drift...");
            lv_obj_set_style_text_color(knob_drift_status_label, lv_color_hex(THEME_COLOR_WARNING), 0);
        }
        if (knob_drift_detail_label) {
            lv_label_set_text(knob_drift_detail_label, "Sampling initial point...");
        }
        if (knob_drift_save_button) {
            lv_obj_add_state(knob_drift_save_button, LV_STATE_DISABLED);
            lv_obj_set_style_bg_color(knob_drift_save_button, lv_color_hex(0x555555), 0);
        }
    } else {
        lv_obj_add_flag(knob_drift_cal_container, LV_OBJ_FLAG_HIDDEN);
        if (knob_drift_cal_button) {
            lv_obj_clear_flag(knob_drift_cal_button, LV_OBJ_FLAG_HIDDEN);
        }
    }
}

void MenuScreen::update_drift_cal_progress(const HallSensor::DriftCalStatus& status) {
    if (!knob_drift_cal_container || !status.in_progress) return;

    if (knob_drift_status_label) {
        if (status.is_complete) {
            lv_label_set_text(knob_drift_status_label, "Calibration Complete!\n(180 points collected)");
            lv_obj_set_style_text_color(knob_drift_status_label, lv_color_hex(THEME_COLOR_SUCCESS), 0);
        } else {
            uint32_t total_sec = status.elapsed_ms / 1000;
            uint32_t min = total_sec / 60;
            uint32_t sec = total_sec % 60;
            char buf[48];
            snprintf(buf, sizeof(buf), "Sampling: %02lu:%02lu / 15:00",
                     static_cast<unsigned long>(min), static_cast<unsigned long>(sec));
            lv_label_set_text(knob_drift_status_label, buf);
            lv_obj_set_style_text_color(knob_drift_status_label, lv_color_hex(THEME_COLOR_WARNING), 0);
        }
    }

    if (knob_drift_detail_label) {
        char buf[128];
        float delta_t = status.current_temp - status.start_temp;
        int32_t delta_adc = status.current_adc - status.start_adc;
        if (status.is_complete) {
            snprintf(buf, sizeof(buf), "T: %.1f->%.1f C (%+.1f C)\nADC: %ld->%ld (%+ld)\nFit: %.2f cnt/C\nTap SAVE to apply",
                     status.start_temp, status.current_temp, delta_t,
                     static_cast<long>(status.start_adc), static_cast<long>(status.current_adc), static_cast<long>(delta_adc),
                     status.calculated_coeff);
        } else if (status.has_valid_fit) {
            snprintf(buf, sizeof(buf), "T: %.1f->%.1f C (%+.1f C)\nADC: %ld->%ld (%+ld)\nFit: %.2f cnt/C",
                     status.start_temp, status.current_temp, delta_t,
                     static_cast<long>(status.start_adc), static_cast<long>(status.current_adc), static_cast<long>(delta_adc),
                     status.calculated_coeff);
        } else {
            snprintf(buf, sizeof(buf), "T: %.1f->%.1f C (%+.1f C)\nADC: %ld->%ld (%+ld)\nWarming up...",
                     status.start_temp, status.current_temp, delta_t,
                     static_cast<long>(status.start_adc), static_cast<long>(status.current_adc), static_cast<long>(delta_adc));
        }
        lv_label_set_text(knob_drift_detail_label, buf);
    }

    if (knob_drift_save_button) {
        if (status.has_valid_fit) {
            lv_obj_clear_state(knob_drift_save_button, LV_STATE_DISABLED);
            lv_obj_set_style_bg_color(knob_drift_save_button, lv_color_hex(THEME_COLOR_SUCCESS), 0);
        } else {
            lv_obj_add_state(knob_drift_save_button, LV_STATE_DISABLED);
            lv_obj_set_style_bg_color(knob_drift_save_button, lv_color_hex(0x555555), 0);
        }
    }
}

void MenuScreen::update_hall_calibration_display(const HallSensor* hall) {
    if (!hall) return;
    for (int i = 0; i < HW_HALL_NUM_CAL_POINTS; i++) {
        bool valid = hall->is_point_calibrated(i);
        int32_t adc = hall->get_point_adc(i);
        update_hall_point_status(i, adc, valid);
    }
}

void MenuScreen::update_hall_point_status(int point_index, int32_t adc, bool valid) {
    if (point_index < 0 || point_index >= HW_HALL_NUM_CAL_POINTS) return;
    if (!knob_cal_status_labels[point_index]) return;

    if (valid) {
        char buffer[32];
        snprintf(buffer, sizeof(buffer), "ADC: %ld", adc);
        lv_label_set_text(knob_cal_status_labels[point_index], buffer);
        lv_obj_set_style_text_color(knob_cal_status_labels[point_index], lv_color_hex(THEME_COLOR_SUCCESS), 0);
    } else {
        lv_label_set_text(knob_cal_status_labels[point_index], "Not set");
        lv_obj_set_style_text_color(knob_cal_status_labels[point_index], lv_color_hex(THEME_COLOR_TEXT_SECONDARY), 0);
    }
}

int MenuScreen::get_read_button_index(lv_obj_t* btn) const {
    for (int i = 0; i < HW_HALL_NUM_CAL_POINTS; i++) {
        if (knob_cal_read_buttons[i] == btn) {
            return i;
        }
    }
    return -1;
}

void MenuScreen::update_grind_mode_toggles() {
    // Read swipe enabled from "swipe" namespace
    Preferences swipe_prefs;
    swipe_prefs.begin("swipe", true); // read-only
    bool swipe_enabled = swipe_prefs.getBool("enabled", false);
    swipe_prefs.end();

    // Read current grind mode from main grinder preferences using hardware manager
    int mode_index = 0; // Default to Weight (index 0)
    int grinder_purge_mode_index = GRIND_PURGE_MODE_DEFAULT;  // Default to Purge
    float grinder_purge_amount_g = GRIND_PURGE_AMOUNT_DEFAULT_G;  // Default to 1.0g
    if (hardware_manager) {
        Preferences* main_prefs = hardware_manager->get_preferences();
        if (main_prefs) {
            int stored_mode = main_prefs->getInt("grind_mode", static_cast<int>(GrindMode::WEIGHT));
            mode_index = (stored_mode == static_cast<int>(GrindMode::TIME)) ? 1 : 0;
            grinder_purge_mode_index = main_prefs->getInt(GrindController::PREF_KEY_GRINDER_MODE, GRIND_PURGE_MODE_DEFAULT);
            grinder_purge_amount_g = main_prefs->getFloat(GrindController::PREF_KEY_GRINDER_AMOUNT_G, GRIND_PURGE_AMOUNT_DEFAULT_G);
        }
    }

    if (grind_mode_radio_group) {
        radio_button_group_set_selection(grind_mode_radio_group, mode_index);
    }

    if (grind_mode_swipe_toggle) {
        if (swipe_enabled) {
            lv_obj_add_state(grind_mode_swipe_toggle, LV_STATE_CHECKED);
        } else {
            lv_obj_clear_state(grind_mode_swipe_toggle, LV_STATE_CHECKED);
        }
    }

    // Auto actions toggles (defaults disabled)
    Preferences auto_prefs;
    auto_prefs.begin("autogrind", true);
    bool auto_start_enabled = auto_prefs.getBool("auto_start", false);
    bool auto_return_enabled = auto_prefs.getBool("auto_return", false);
    float auto_start_threshold_g = auto_prefs.getFloat("start_delta_g", USER_AUTO_GRIND_TRIGGER_DELTA_G);
    auto_prefs.end();
    auto_start_threshold_g = std::clamp(auto_start_threshold_g,
                                        USER_AUTO_GRIND_TRIGGER_MIN_G,
                                        USER_AUTO_GRIND_TRIGGER_MAX_G);

    if (auto_start_toggle) {
        if (auto_start_enabled) {
            lv_obj_add_state(auto_start_toggle, LV_STATE_CHECKED);
        } else {
            lv_obj_clear_state(auto_start_toggle, LV_STATE_CHECKED);
        }
    }

    if (auto_return_toggle) {
        if (auto_return_enabled) {
            lv_obj_add_state(auto_return_toggle, LV_STATE_CHECKED);
        } else {
            lv_obj_clear_state(auto_return_toggle, LV_STATE_CHECKED);
        }
    }

    if (auto_start_threshold_slider) {
        const int slider_value = static_cast<int>(auto_start_threshold_g * kAutoStartThresholdSliderScale + 0.5f);
        lv_slider_set_value(auto_start_threshold_slider, slider_value, LV_ANIM_OFF);
    }
    update_auto_start_threshold_label(auto_start_threshold_g);

    // Update grinder purge mode radio group selection
    if (grinder_purge_mode_radio_group) {
        radio_button_group_set_selection(grinder_purge_mode_radio_group, grinder_purge_mode_index);
    }

    grinder_purge_amount_g = std::clamp(grinder_purge_amount_g, GRIND_PURGE_AMOUNT_MIN_G, GRIND_PURGE_AMOUNT_MAX_G);
    const int slider_min_units = static_cast<int>(GRIND_PURGE_AMOUNT_MIN_G * kPurgeSliderScale + 0.5f);
    const int slider_max_units = static_cast<int>(GRIND_PURGE_AMOUNT_MAX_G * kPurgeSliderScale + 0.5f);

    // Update grinder purge amount slider using kPurgeSliderScale (0.1g resolution)
    if (grinder_purge_amount_slider) {
        int slider_value = static_cast<int>(grinder_purge_amount_g * kPurgeSliderScale + 0.5f);
        slider_value = std::clamp(slider_value, slider_min_units, slider_max_units);
        lv_slider_set_value(grinder_purge_amount_slider, slider_value, LV_ANIM_OFF);
    }

    // Update grinder purge amount label
    update_grinder_purge_amount_label(grinder_purge_amount_g);

    // Load and set grind freshness hours
    float freshness_hours = GRIND_FRESHNESS_DEFAULT_HOURS;
    if (hardware_manager) {
        Preferences* main_prefs = hardware_manager->get_preferences();
        if (main_prefs) {
            freshness_hours = main_prefs->getFloat(GrindController::PREF_KEY_GRIND_FRESHNESS_HOURS, GRIND_FRESHNESS_DEFAULT_HOURS);
        }
    }

    // Map hours to slider index (discrete steps: 0.5, 1, 2, 3, 4, 8, 12, 24, 48)
    static const float freshness_steps[] = {0.5f, 1.0f, 2.0f, 3.0f, 4.0f, 8.0f, 12.0f, 24.0f, 48.0f};
    int slider_index = 5; // Default to 8h
    for (int i = 0; i < 9; i++) {
        if (fabsf(freshness_hours - freshness_steps[i]) < 0.1f) {
            slider_index = i;
            break;
        }
    }

    if (grind_freshness_hours_slider) {
        lv_slider_set_value(grind_freshness_hours_slider, slider_index, LV_ANIM_OFF);
    }

    update_grind_freshness_hours_label(freshness_hours);

    // Load and set coast ratio
    float coast_ratio = GRIND_LATENCY_TO_COAST_RATIO_DEFAULT;
    if (grind_controller) {
        coast_ratio = grind_controller->get_coast_ratio();
    }

    if (coast_ratio_slider) {
        int slider_value = static_cast<int>(coast_ratio * kCoastRatioSliderScale + 0.5f);
        const int coast_slider_min = static_cast<int>(GRIND_LATENCY_TO_COAST_RATIO_MIN * kCoastRatioSliderScale + 0.5f);
        const int coast_slider_max = static_cast<int>(GRIND_LATENCY_TO_COAST_RATIO_MAX * kCoastRatioSliderScale + 0.5f);
        slider_value = std::clamp(slider_value, coast_slider_min, coast_slider_max);
        lv_slider_set_value(coast_ratio_slider, slider_value, LV_ANIM_OFF);
    }

    update_coast_ratio_label(coast_ratio);

    float motor_latency_ms = GRIND_MOTOR_RESPONSE_LATENCY_DEFAULT_MS;
    if (grind_controller) {
        motor_latency_ms = grind_controller->get_motor_response_latency();
    }
    if (motor_latency_slider) {
        const int slider_value = static_cast<int>(motor_latency_ms + 0.5f);
        lv_slider_set_value(motor_latency_slider, slider_value, LV_ANIM_OFF);
    }
    update_motor_latency_label(motor_latency_ms);
}
