PaulT95/smart-grind-by-weight/src/ui/screens/menu_screen.h

#pragma once
#include <lvgl.h>
#include "../../config/constants.h"
#include "../../bluetooth/manager.h"
#include "../../controllers/grind_controller.h"
#include "../../system/diagnostics_controller.h"
#include "../../hardware/HallSensor.h"
#include "../ui_helpers.h"

class GrindingScreen;  // Forward declaration

class MenuScreen {
private:
    lv_obj_t* screen;
    lv_obj_t* menu;
    lv_obj_t* info_page;
    lv_obj_t* bluetooth_page;
    lv_obj_t* network_page;
    lv_obj_t* display_page;
    lv_obj_t* grind_mode_page;
    lv_obj_t* data_page;
    lv_obj_t* stats_page;
    lv_obj_t* diagnostics_page;
    lv_obj_t* scale_page;
    lv_obj_t* grind_knob_page;

    // Tools entries / grind knob page elements
    lv_obj_t* grind_knob_item;
    lv_obj_t* knob_dial_label;
    lv_obj_t* knob_adc_label;
    lv_obj_t* knob_comp_adc_label;
    lv_obj_t* knob_temp_label;
    lv_obj_t* knob_cal_status_labels[HW_HALL_NUM_CAL_POINTS];
    lv_obj_t* knob_cal_read_buttons[HW_HALL_NUM_CAL_POINTS];
    lv_obj_t* knob_clear_button;
    lv_obj_t* knob_temp_comp_toggle;
    lv_obj_t* knob_drift_coeff_label;
    lv_obj_t* knob_drift_ref_label;
    lv_obj_t* knob_drift_cal_button;
    lv_obj_t* knob_drift_cal_container;
    lv_obj_t* knob_drift_status_label;
    lv_obj_t* knob_drift_detail_label;
    lv_obj_t* knob_drift_save_button;
    lv_obj_t* knob_drift_cancel_button;
    bool grind_knob_active;

    // Info tab elements
    lv_obj_t* info_label;
    lv_obj_t* uptime_label;
    lv_obj_t* memory_label;
    lv_obj_t* instant_label;
    lv_obj_t* samples_label;
    lv_obj_t* raw_label;
    lv_obj_t* sessions_label;
    lv_obj_t* events_label;
    lv_obj_t* measurements_label;
    lv_obj_t* refresh_stats_button;

    // Lifetime statistics labels
    lv_obj_t* stat_total_grinds_label;
    lv_obj_t* stat_shots_label;
    lv_obj_t* stat_motor_runtime_label;
    lv_obj_t* stat_device_uptime_label;
    lv_obj_t* stat_total_weight_label;
    lv_obj_t* stat_mode_grinds_label;
    lv_obj_t* stat_avg_accuracy_label;
    lv_obj_t* stat_total_pulses_label;
    
    // Menu toggle elements
    lv_obj_t* ble_toggle;
    lv_obj_t* ble_startup_toggle;
    lv_obj_t* ble_status_label;
    lv_obj_t* ble_timer_label;
    lv_obj_t* network_status_label;
    lv_obj_t* network_detail_label;
    lv_obj_t* network_qr;
    lv_obj_t* network_update_label;
    lv_obj_t* network_update_button;
    String network_status_text;
    String network_detail_text;
    String network_qr_payload;
    String network_update_text;
    bool network_update_button_visible;
    lv_obj_t* logging_toggle;
    lv_obj_t* brightness_normal_slider;
    lv_obj_t* brightness_screensaver_slider;
    lv_obj_t* brightness_normal_label;
    lv_obj_t* brightness_screensaver_label;
    lv_obj_t* screensaver_startup_toggle;
    lv_obj_t* screensaver_sleep_toggle;
    lv_obj_t* display_off_toggle;
    lv_obj_t* purge_button;
    lv_obj_t* reset_button;
    
    // Grind mode tab elements
    lv_obj_t* grind_mode_radio_group;
    lv_obj_t* grind_mode_swipe_toggle;
    lv_obj_t* auto_start_toggle;
    lv_obj_t* auto_start_threshold_slider;
    lv_obj_t* auto_start_threshold_label;
    lv_obj_t* auto_return_toggle;
    lv_obj_t* grinder_purge_mode_radio_group;
    lv_obj_t* grinder_purge_amount_slider;
    lv_obj_t* grinder_purge_amount_label;
    lv_obj_t* grind_freshness_hours_slider;
    lv_obj_t* grind_freshness_hours_label;
    lv_obj_t* coast_ratio_slider;
    lv_obj_t* coast_ratio_label;
    lv_obj_t* motor_latency_slider;
    lv_obj_t* motor_latency_label;

    // Tools entries / scale page elements
    lv_obj_t* scale_item;
    lv_obj_t* cal_button;
    lv_obj_t* motor_test_button;
    lv_obj_t* autotune_button;
    lv_obj_t* scale_weight_label;
    lv_obj_t* scale_tare_button;

    // Diagnostics tab elements
    lv_obj_t* diag_status_label;
    lv_obj_t* diag_calibration_factor_label;
    lv_obj_t* diag_std_dev_g_label;
    lv_obj_t* diag_std_dev_adc_label;
    lv_obj_t* diag_noise_level_label;
    lv_obj_t* diag_motor_latency_label;
    lv_obj_t* diag_info_label;
    lv_obj_t* diag_reset_button;

    // Common elements
    bool visible;
    bool scale_active;
    
    BluetoothManager* bluetooth_manager;
    GrindController* grind_controller;
    GrindingScreen* grinding_screen;
    class HardwareManager* hardware_manager; // Forward declaration to access preferences
    DiagnosticsController* diagnostics_controller;

public:
    static constexpr float kPurgeSliderScale = 10.0f; // Slider uses 0.1g increments
    static constexpr float kCoastRatioSliderScale = 20.0f; // Slider uses 0.05 increments
    static constexpr float kAutoStartThresholdSliderScale = 1.0f / USER_AUTO_GRIND_TRIGGER_STEP_G;
    static constexpr int kMotorLatencySliderStepMs =
        static_cast<int>(GRIND_MOTOR_LATENCY_MANUAL_STEP_MS);

    void create(BluetoothManager* bluetooth, GrindController* grind_ctrl, GrindingScreen* grind_screen, class HardwareManager* hw_mgr, DiagnosticsController* diag_ctrl);
    void show();
    void hide();
    void update_info(const WeightSensor* weight_sensor, unsigned long uptime_ms, size_t free_heap);
    void update_diagnostics(WeightSensor* weight_sensor);
    void update_ble_status();
    void update_network_status();
    void refresh_statistics(bool show_overlay = true);
    void update_brightness_labels(int normal_percent = -1, int screensaver_percent = -1); // Use negative value to leave unchanged
    void update_brightness_sliders();
    void update_bluetooth_startup_toggle();
    void update_logging_toggle();
    void update_grind_mode_toggles();
    void update_auto_start_threshold_label(float threshold_g);
    void update_grinder_purge_amount_label(float amount_g);
    void update_grind_freshness_hours_label(float hours);
    void update_coast_ratio_label(float ratio);
    void update_motor_latency_label(float latency_ms);
    void reset_scale_display();
    void update_scale_weight(float weight);
    void reset_grind_knob_display();
    void update_grind_knob_display(float dial, int32_t raw_adc, int32_t comp_adc = -1, float temp_c = NAN);
    void update_hall_calibration_display(const class HallSensor* hall);
    void update_drift_compensation_display(const class HallSensor* hall);
    void show_drift_cal_panel(bool show);
    void update_drift_cal_progress(const HallSensor::DriftCalStatus& status);
    void update_hall_point_status(int point_index, int32_t adc, bool valid);
    int get_read_button_index(lv_obj_t* btn) const;

    bool is_visible() const { return visible; }
    lv_obj_t* get_screen() const { return screen; }
    lv_obj_t* get_tabview() const { return menu; }
    lv_obj_t* get_diagnostics_page() const { return diagnostics_page; }
    lv_obj_t* get_cal_button() const { return cal_button; }
    lv_obj_t* get_purge_button() const { return purge_button; }
    lv_obj_t* get_reset_button() const { return reset_button; }
    lv_obj_t* get_motor_test_button() const { return motor_test_button; }
    lv_obj_t* get_autotune_button() const { return autotune_button; }
    bool is_scale_page_active() const { return scale_active; }
    bool is_grind_knob_page_active() const { return grind_knob_active; }
    lv_obj_t* get_grind_knob_clear_button() const { return knob_clear_button; }
    lv_obj_t* get_knob_temp_comp_toggle() const { return knob_temp_comp_toggle; }
    lv_obj_t* get_knob_drift_cal_button() const { return knob_drift_cal_button; }
    lv_obj_t* get_knob_drift_save_button() const { return knob_drift_save_button; }
    lv_obj_t* get_knob_drift_cancel_button() const { return knob_drift_cancel_button; }
    lv_obj_t* get_ble_toggle() const { return ble_toggle; }
    lv_obj_t* get_ble_startup_toggle() const { return ble_startup_toggle; }
    lv_obj_t* get_logging_toggle() const { return logging_toggle; }
    lv_obj_t* get_refresh_stats_button() const { return refresh_stats_button; }
    lv_obj_t* get_network_update_button() const { return network_update_button; }
    lv_obj_t* get_diag_reset_button() const { return diag_reset_button; }
    lv_obj_t* get_brightness_normal_slider() const { return brightness_normal_slider; }
    lv_obj_t* get_brightness_screensaver_slider() const { return brightness_screensaver_slider; }
    lv_obj_t* get_grind_mode_radio_group() const { return grind_mode_radio_group; }
    lv_obj_t* get_grind_mode_swipe_toggle() const { return grind_mode_swipe_toggle; }
    lv_obj_t* get_auto_start_toggle() const { return auto_start_toggle; }
    lv_obj_t* get_auto_start_threshold_slider() const { return auto_start_threshold_slider; }
    lv_obj_t* get_auto_return_toggle() const { return auto_return_toggle; }
    lv_obj_t* get_grinder_purge_mode_radio_group() const { return grinder_purge_mode_radio_group; }
    lv_obj_t* get_grinder_purge_amount_slider() const { return grinder_purge_amount_slider; }
    lv_obj_t* get_grind_freshness_hours_slider() const { return grind_freshness_hours_slider; }
    lv_obj_t* get_coast_ratio_slider() const { return coast_ratio_slider; }
    lv_obj_t* get_motor_latency_slider() const { return motor_latency_slider; }
    lv_obj_t* get_screensaver_startup_toggle() const { return screensaver_startup_toggle; }
    lv_obj_t* get_screensaver_sleep_toggle() const { return screensaver_sleep_toggle; }
    lv_obj_t* get_display_off_toggle() const { return display_off_toggle; }
    void update_screensaver_toggles();

private:
    void create_menu_ui();
    void create_info_page(lv_obj_t* parent);
    void create_bluetooth_page(lv_obj_t* parent);
    void create_network_page(lv_obj_t* parent);
    void create_display_page(lv_obj_t* parent);
    void create_grind_mode_page(lv_obj_t* parent);
    void create_scale_page(lv_obj_t* parent);
    void create_grind_knob_page(lv_obj_t* parent);
    void create_data_page(lv_obj_t* parent);
    void create_stats_page(lv_obj_t* parent);
    void create_diagnostics_page(lv_obj_t* parent);
    lv_obj_t* create_separator(lv_obj_t* parent, const char* text = nullptr);
    lv_obj_t* create_menu_item(lv_obj_t* parent, const char* text);
    lv_obj_t *create_toggle_row(lv_obj_t *parent, const char *text,lv_obj_t **out_toggle);
    lv_obj_t *create_slider_row(lv_obj_t *parent, const char *text,
                                lv_obj_t **label, lv_obj_t **slider,
                                lv_color_t slider_color = lv_color_hex(THEME_COLOR_ACCENT),
                                uint32_t min = 0, uint32_t max = 100);
    lv_obj_t *create_static_data_label(lv_obj_t *parent, const char *name,
                                       const char *value);
    lv_obj_t *create_data_label(lv_obj_t *parent, const char *name,
                                lv_obj_t **variable, bool stacked = false);
    lv_obj_t *create_description_label(lv_obj_t *parent, const char *text);
};
