PaulT95/smart-grind-by-weight/(commit log)

2026-10-17 add hall sensor grind knob: calibration, live dial, colored grind type
2026-10-17 docs: changelog entry for hall sensor grind knob
2026-10-31 Update docs for digital grind knob installation and mark feature as experimental
    [Hall_sensor_adapter.stl]
