PaulT95/smart-grind-by-weight/(notices)

Notices in the files:
README.md:
License: GPL v3
